mkokshoorn/Direct-Drive-Electric-Scooter/README.md

# Direct Drive Electric Scooter

This was a final year Electrical Engineering honours project to convert a children’s electric scooter to an electric direct drive scooter. The project achieved a very positive result. Its operation can be seen in the video provided in the main repository directory. A detailed overview of the project can be found in the report directory. Shown below is the scooter before the project began and after.

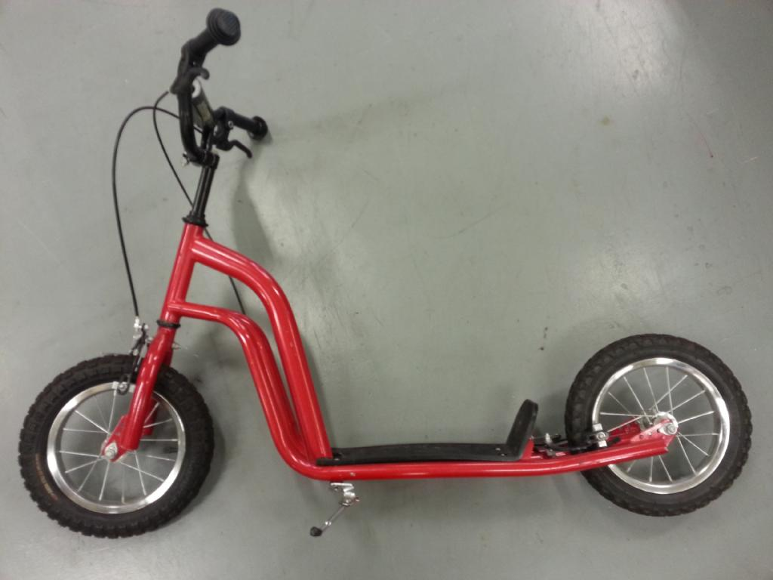
[picture p1: ScooterBefore.jpeg]

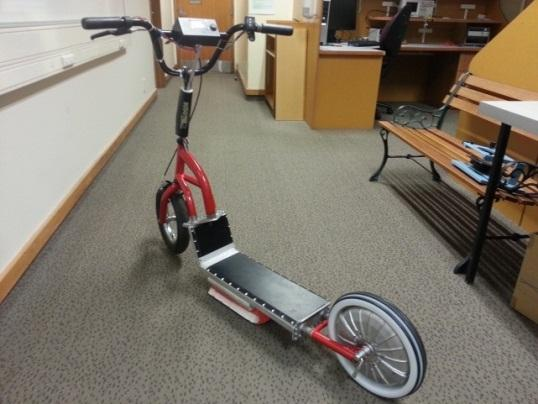
[picture p2: ScooterAfter.jpeg]


## System Overview 

Although this project was very hardware orientated, the source code for the embedded systems component has been provided. The embedded system is based on a PIC microcontroller. In addition to interpreting the user input and control signals, it also relayed information to the rider as shown below. 

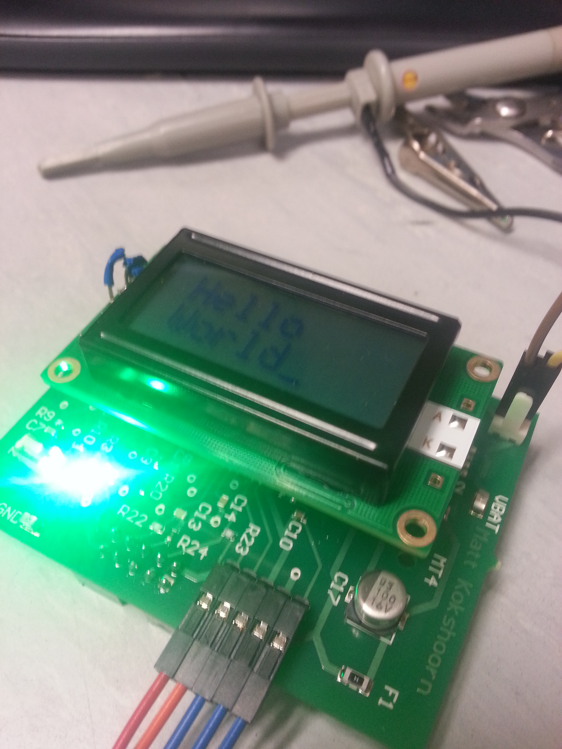
[picture p3: Multimedia/Board with LCD.jpg]


The microcontrollers full role in the system can also be seen in the following functional diagram.

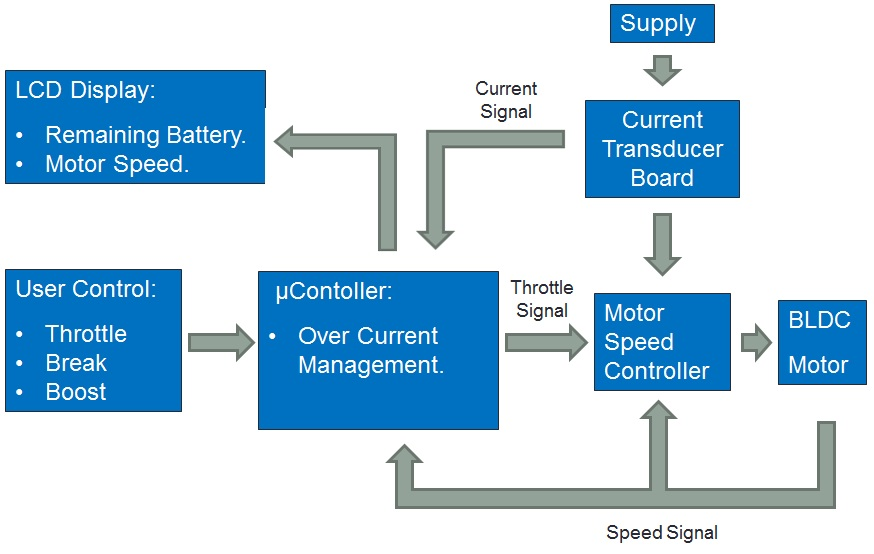
[picture p4: SystemOverview.jpg]


## Schematics and PCB Layouts

In the embedded system directory, the schematics and PCB files can also be found. They are also shown below.

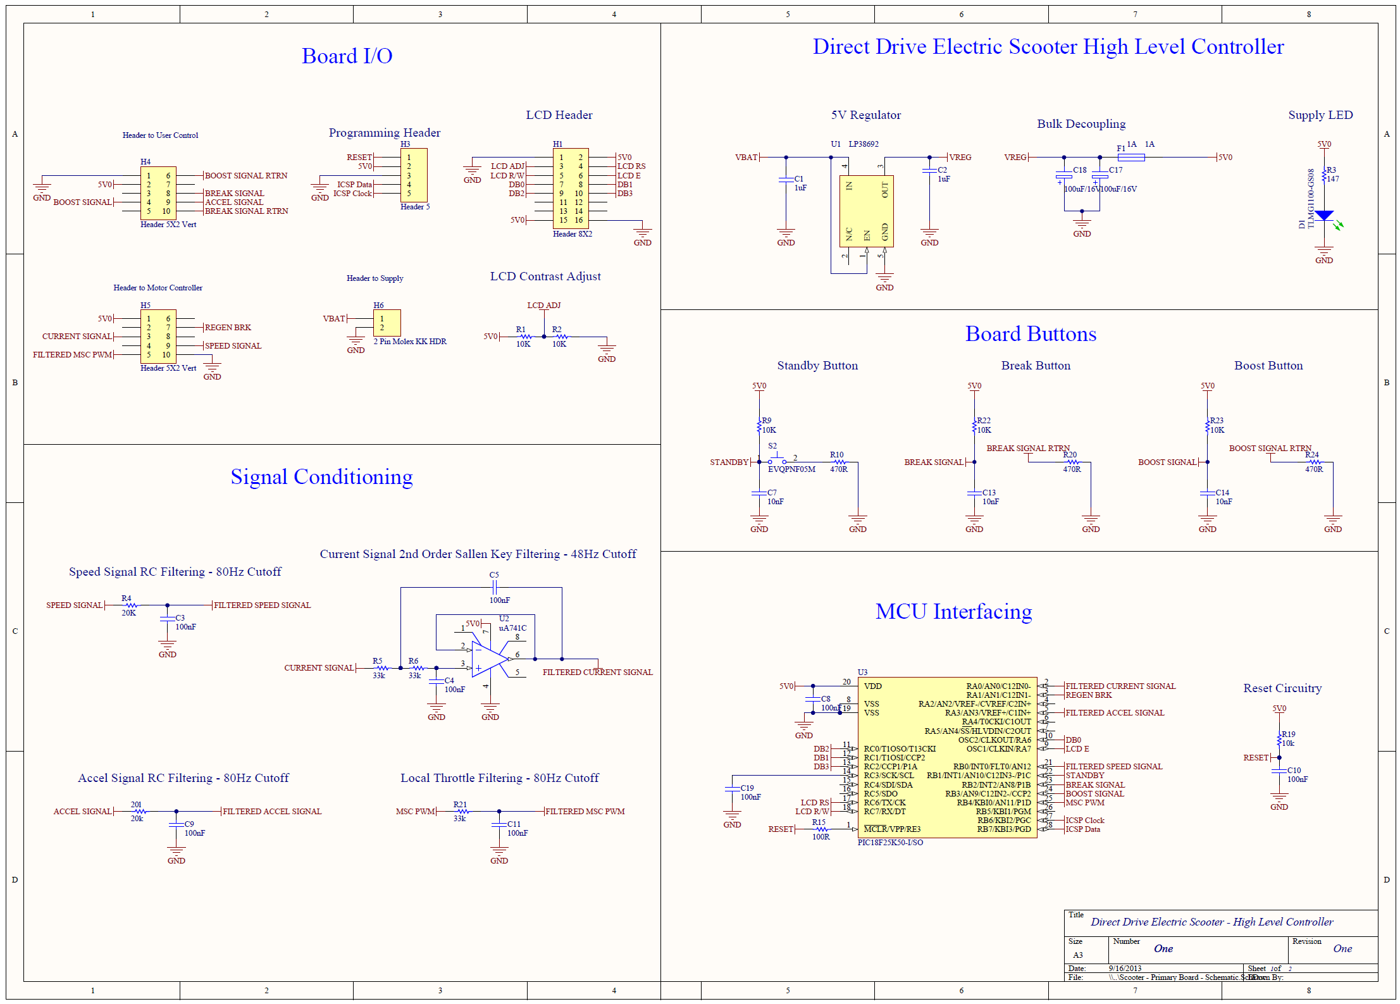
[picture p5: PrimaryBoardSchematic.png]

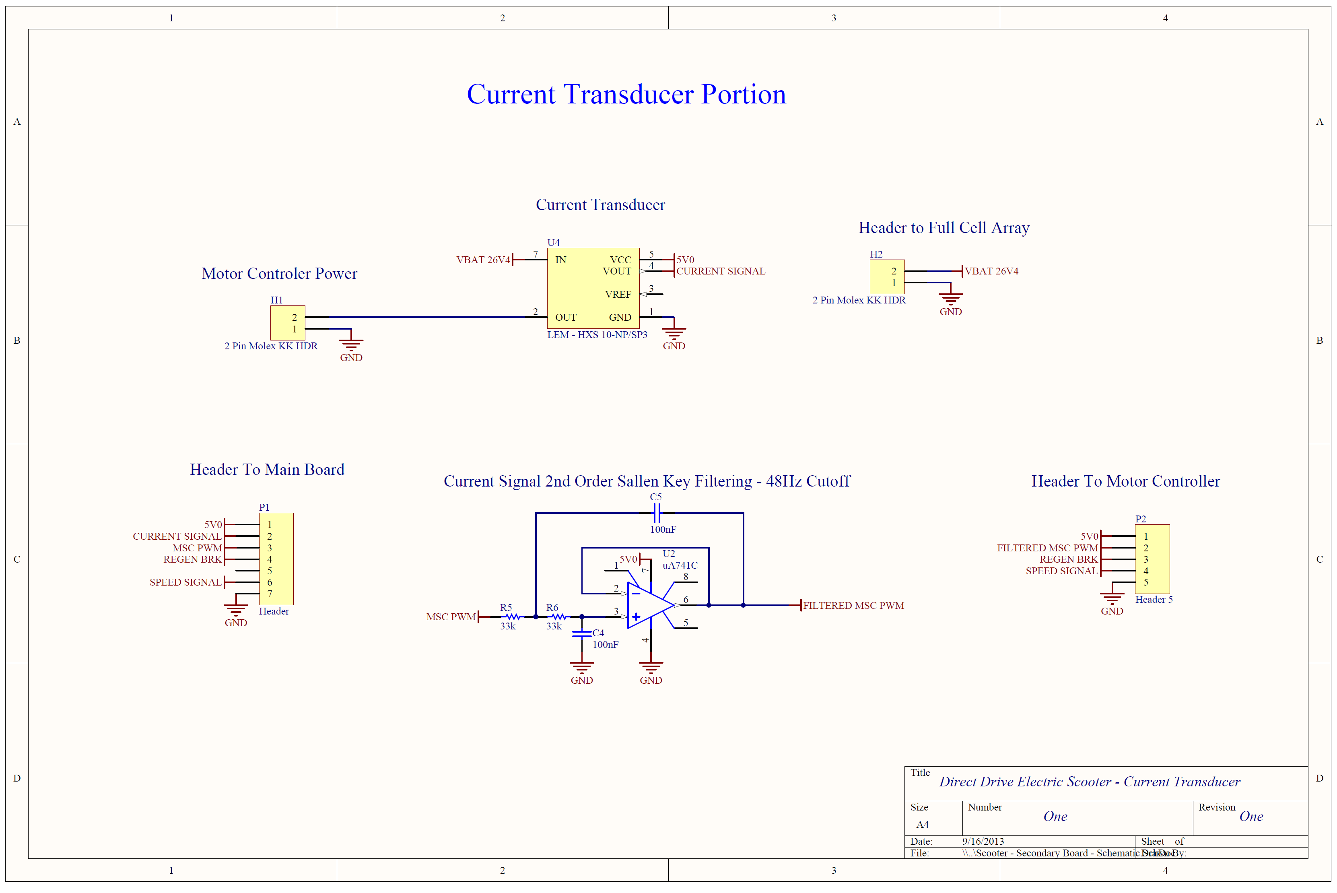
[picture p6: SecondaryBoardSchematic.png]

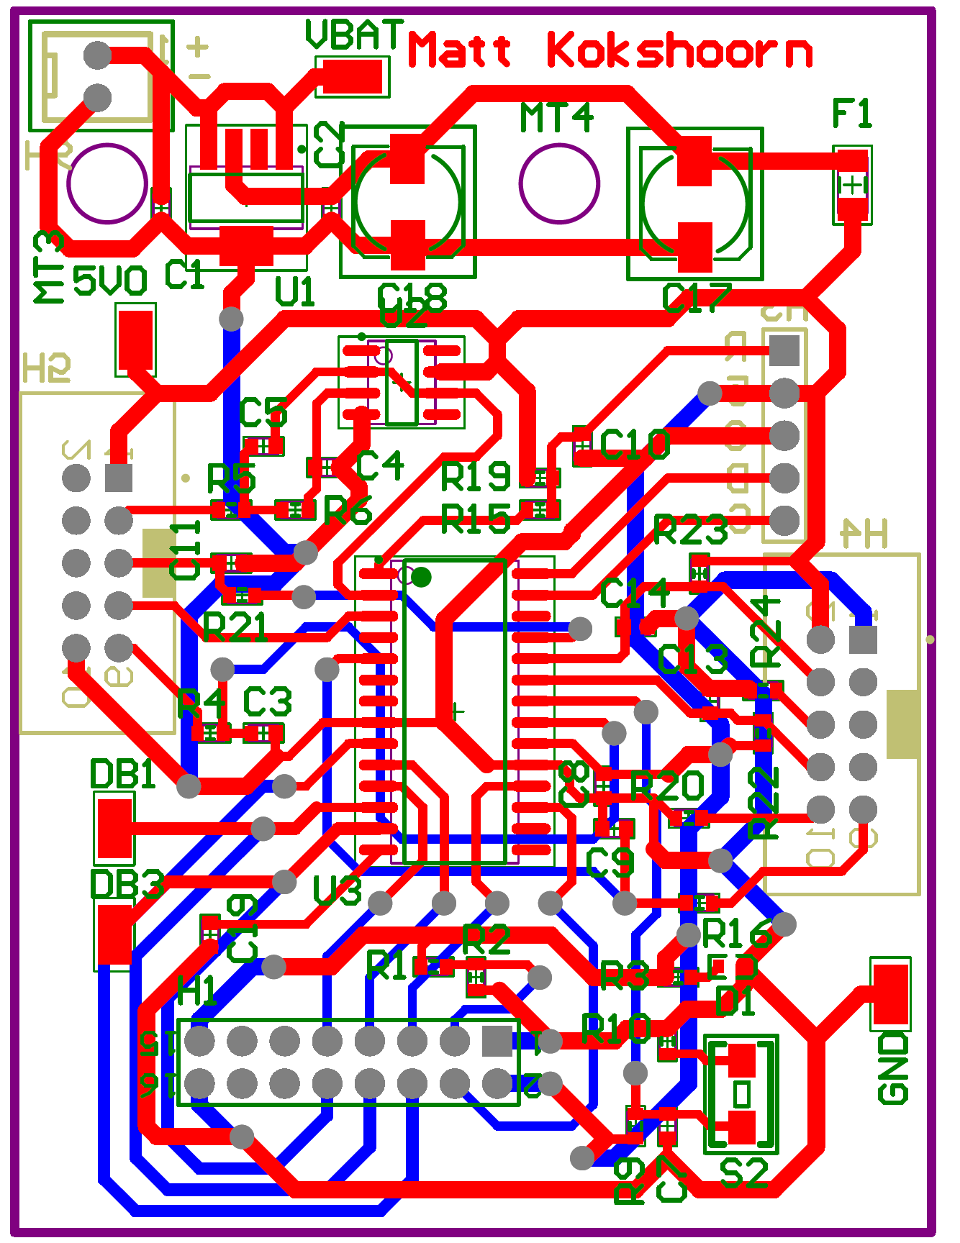
[picture p7: PrimaryBoardPCB.png]

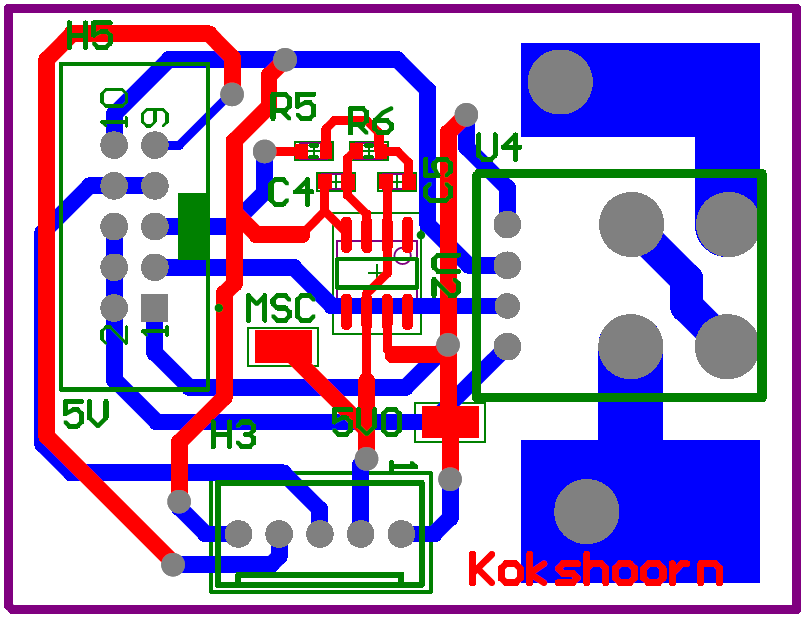
[picture p8: SecondaryBoardPCB.png]


## Solid Modeling 

In order to fabricate the battery housing, much of the frame was modeled in solid works as can be seen below.

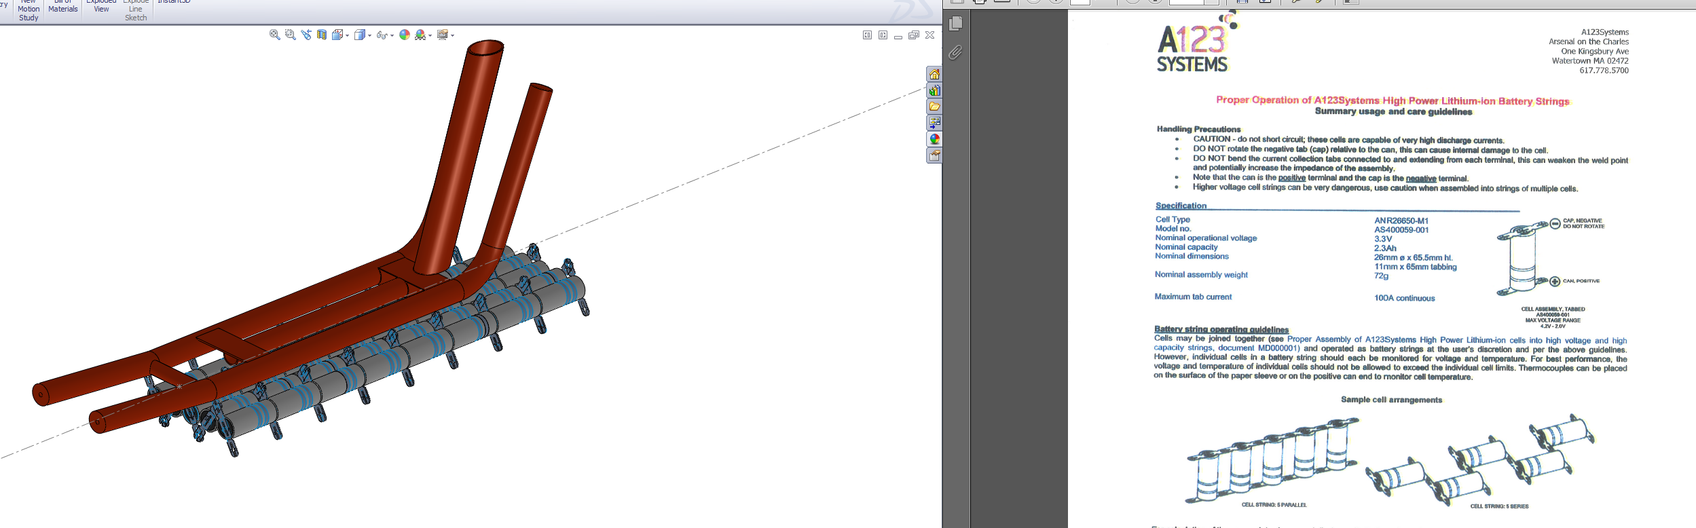
[picture p9: ScooterEarlyModel.png]

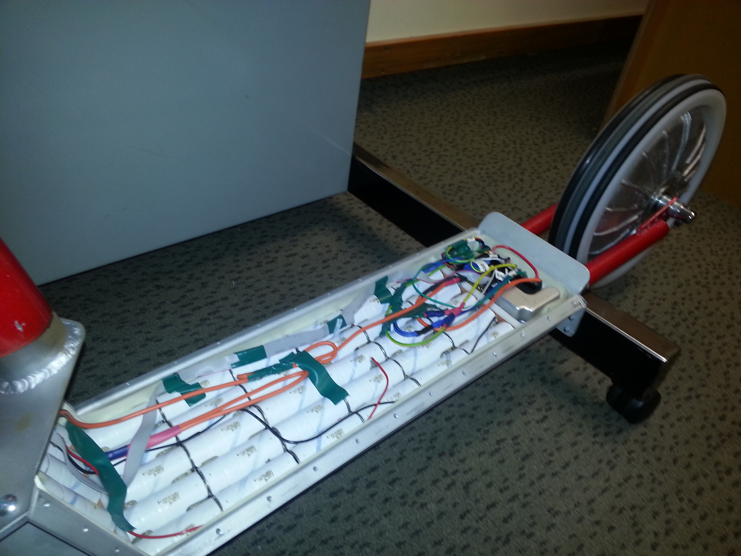
[picture p10: ScooterOpen.jpg]

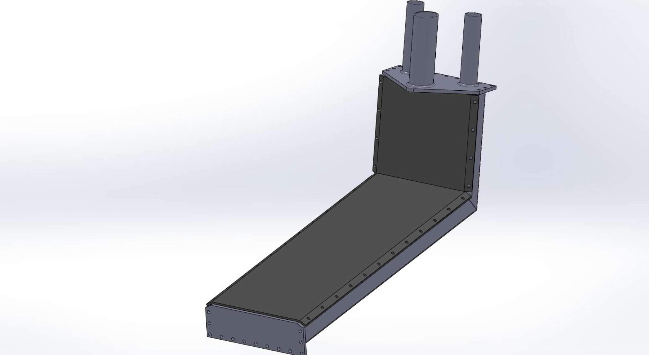
[picture p11: ScooterFinalModel.png]
