mkokshoorn/Direct-Drive-Electric-Scooter/JustBoard.jpg

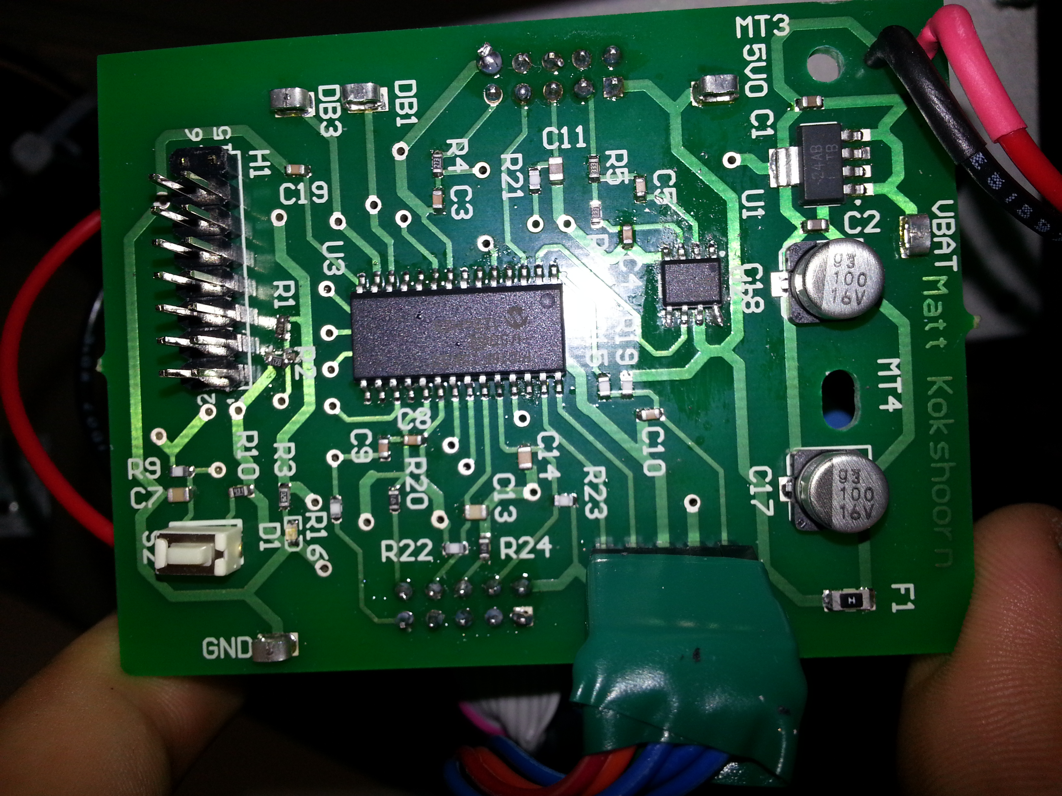
JustBoard.jpg
