mkokshoorn/Direct-Drive-Electric-Scooter/Multimedia/20130307_154826.jpg

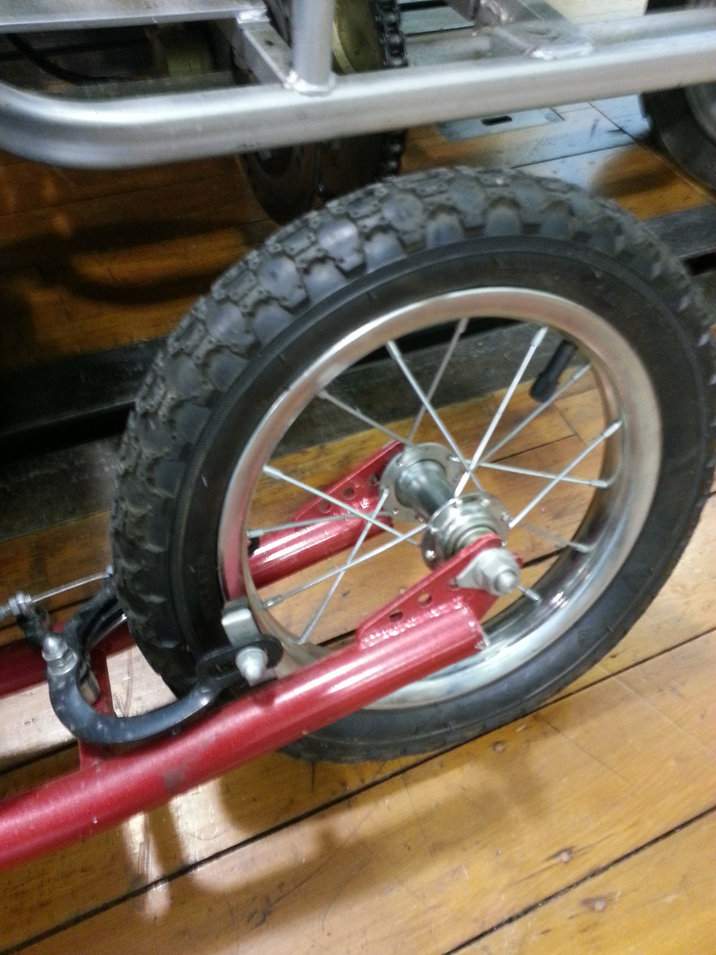
Multimedia/20130307_154826.jpg
