mkokshoorn/Direct-Drive-Electric-Scooter/Multimedia/20130307_154846.jpg

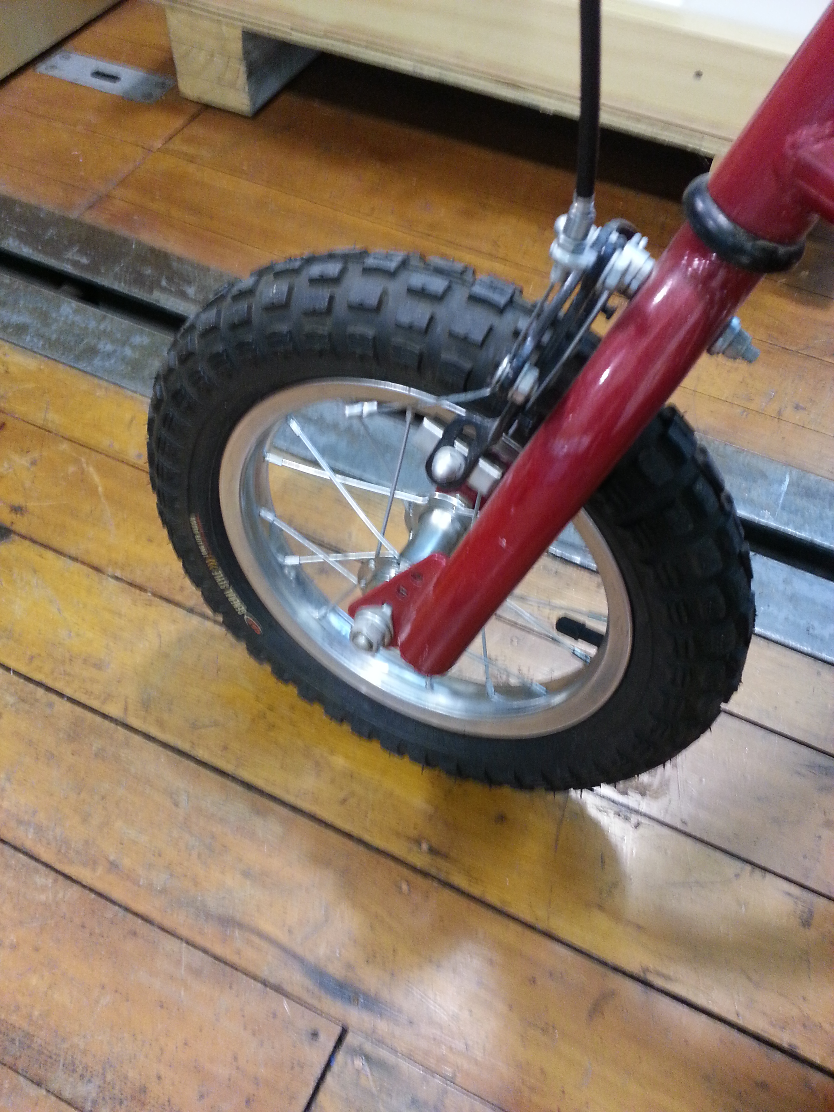
Multimedia/20130307_154846.jpg
