mkokshoorn/Direct-Drive-Electric-Scooter/Multimedia/20130307_154857.jpg

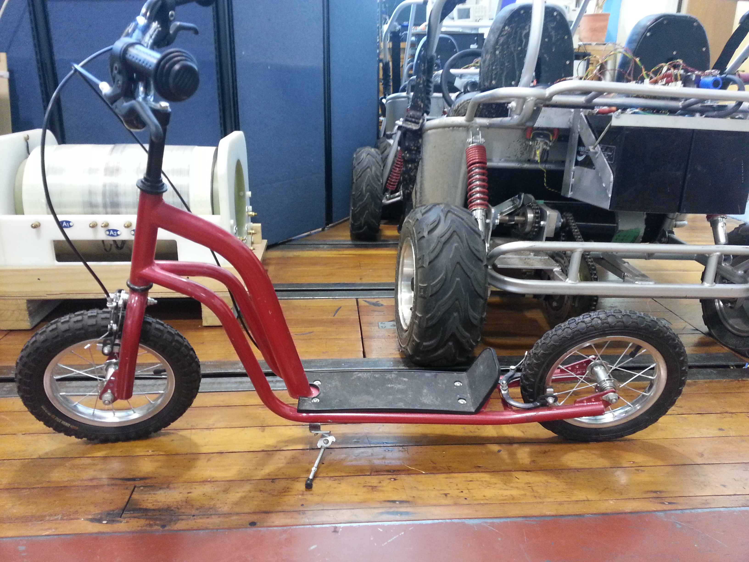
Multimedia/20130307_154857.jpg
