mkokshoorn/Direct-Drive-Electric-Scooter/Multimedia/20130307_154914.jpg

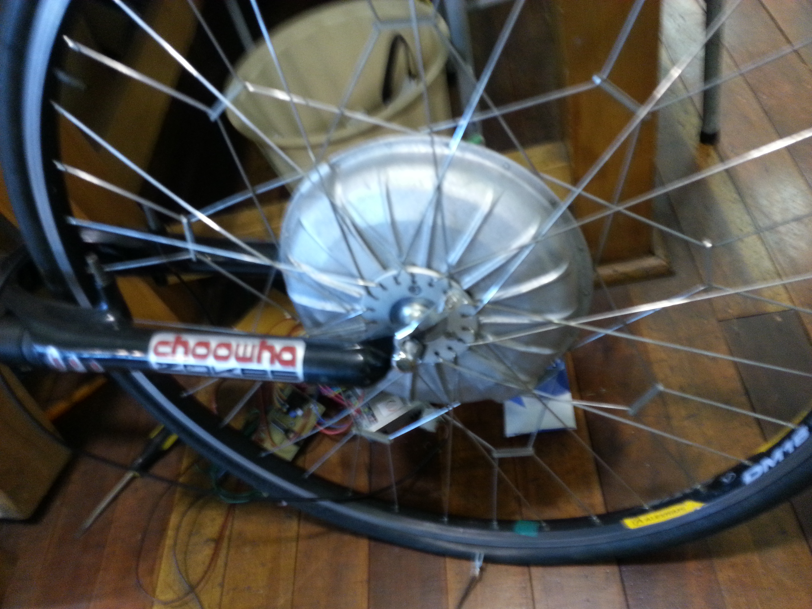
Multimedia/20130307_154914.jpg
