mkokshoorn/Direct-Drive-Electric-Scooter/Multimedia/20130312_115428.jpg

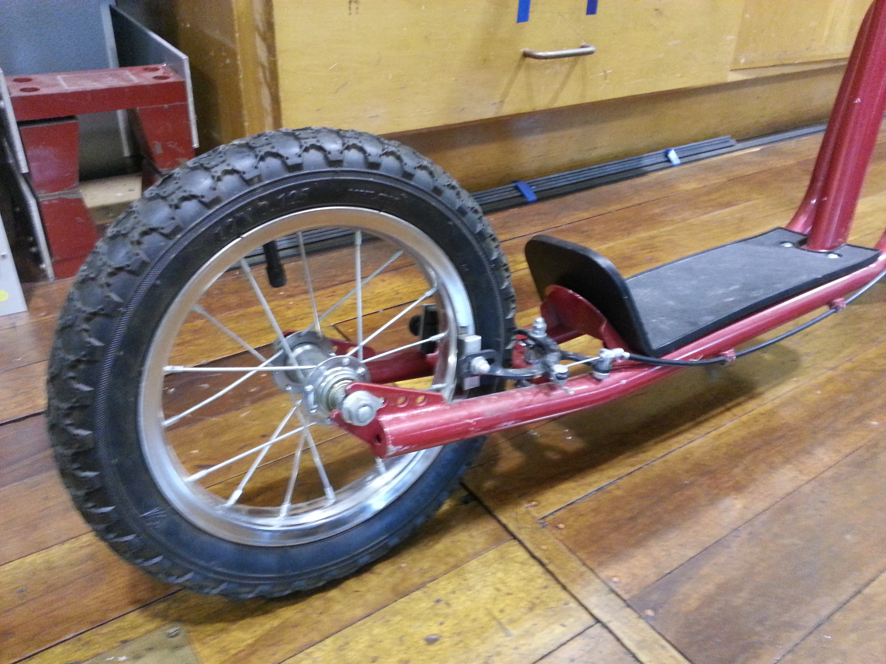
Multimedia/20130312_115428.jpg
