mkokshoorn/Direct-Drive-Electric-Scooter/Multimedia/20130312_115438.jpg

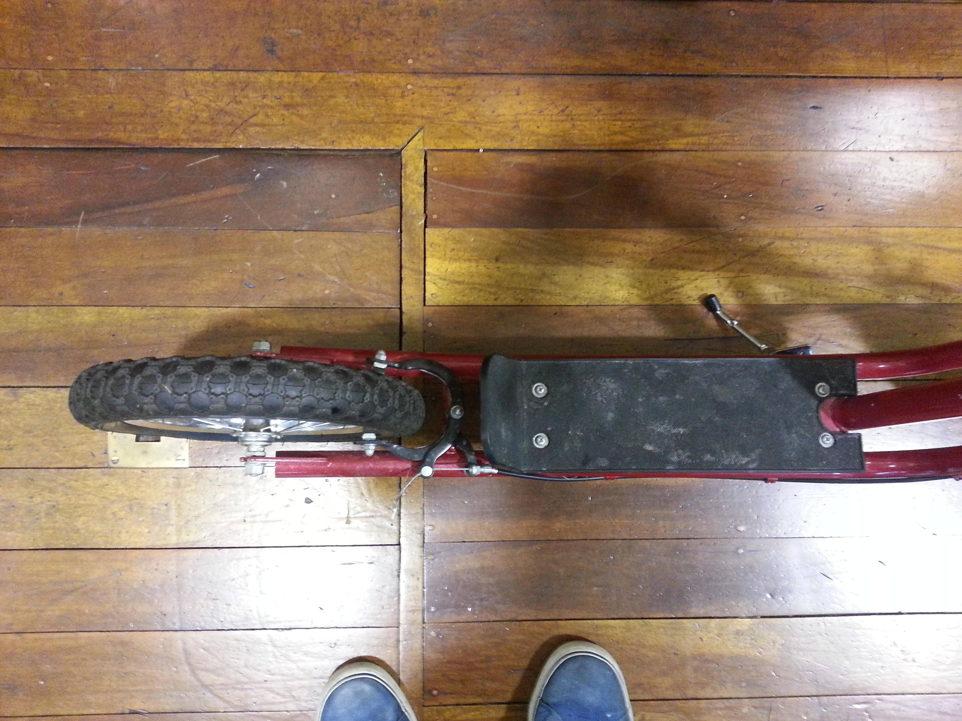
Multimedia/20130312_115438.jpg
