mkokshoorn/Direct-Drive-Electric-Scooter/Multimedia/20130312_115449.jpg

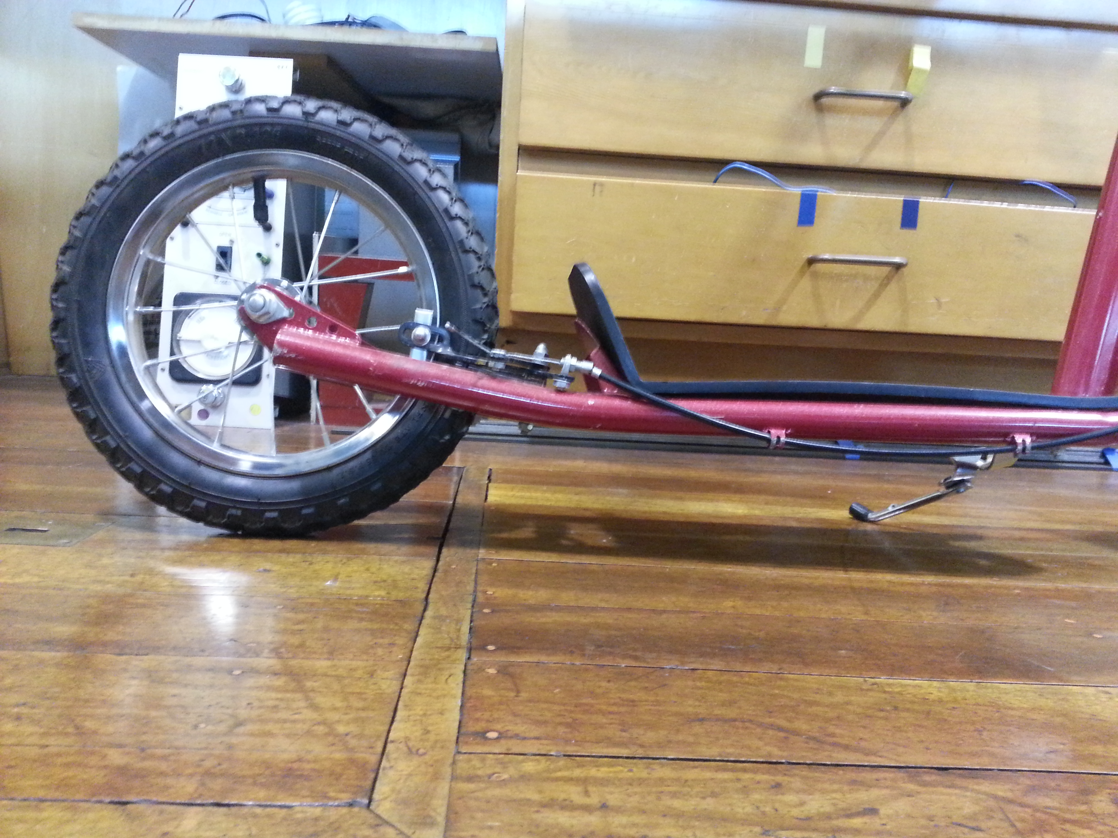
Multimedia/20130312_115449.jpg
