mkokshoorn/Direct-Drive-Electric-Scooter/Multimedia/20130312_115455.jpg

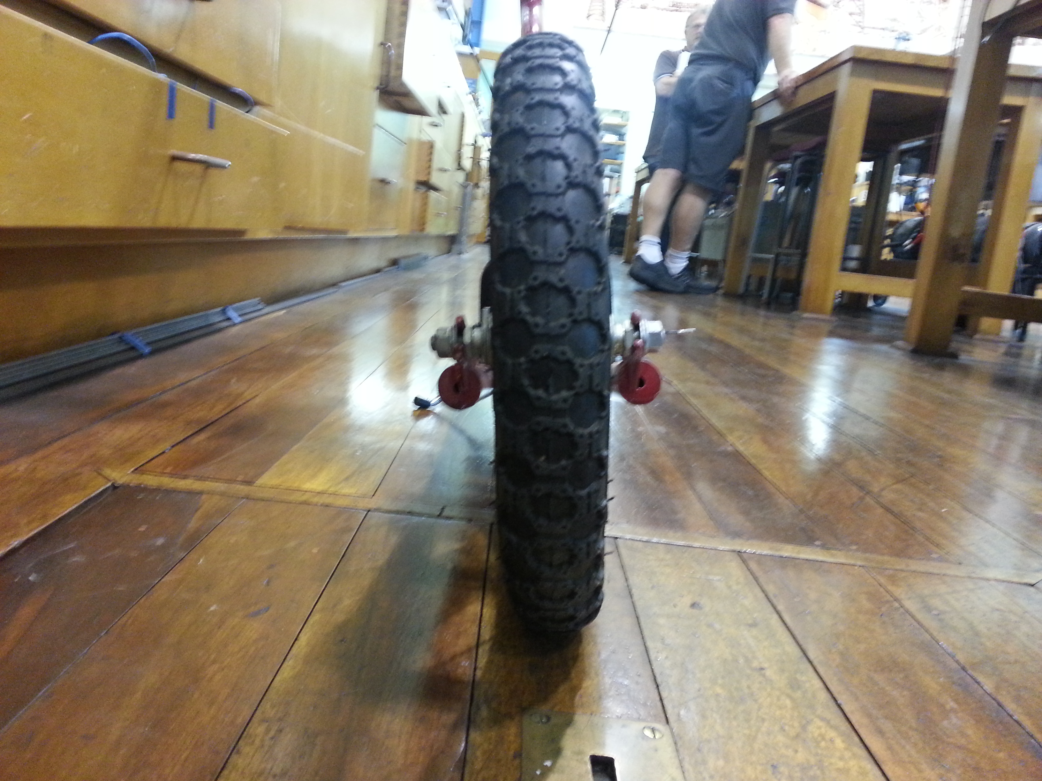
Multimedia/20130312_115455.jpg
