mkokshoorn/Direct-Drive-Electric-Scooter/Multimedia/20130312_115504.jpg

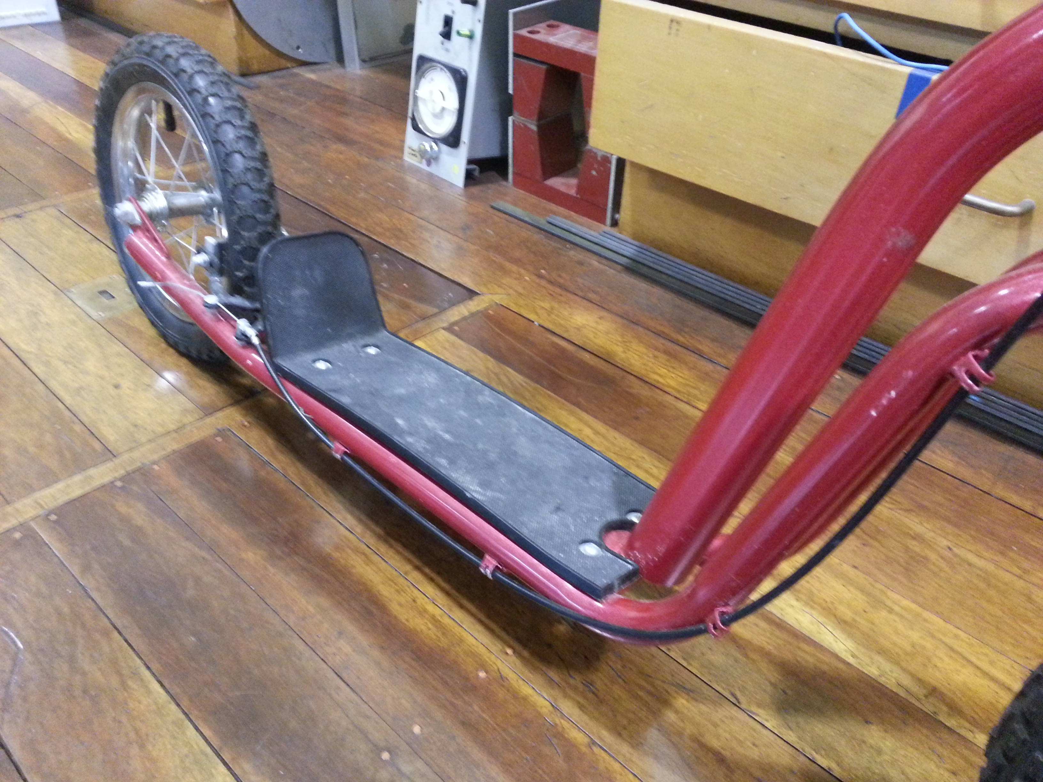
Multimedia/20130312_115504.jpg
