mkokshoorn/Direct-Drive-Electric-Scooter/Multimedia/20130312_115529.jpg

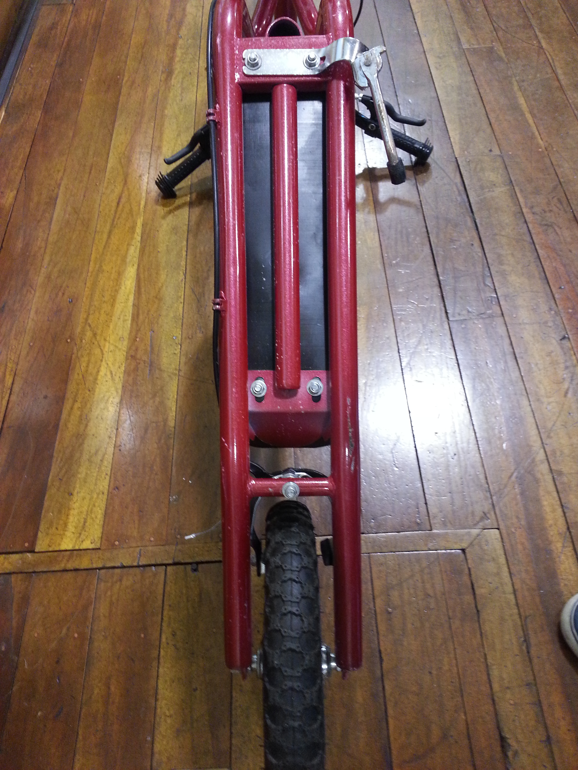
Multimedia/20130312_115529.jpg
