mkokshoorn/Direct-Drive-Electric-Scooter/Multimedia/20130312_115534.jpg

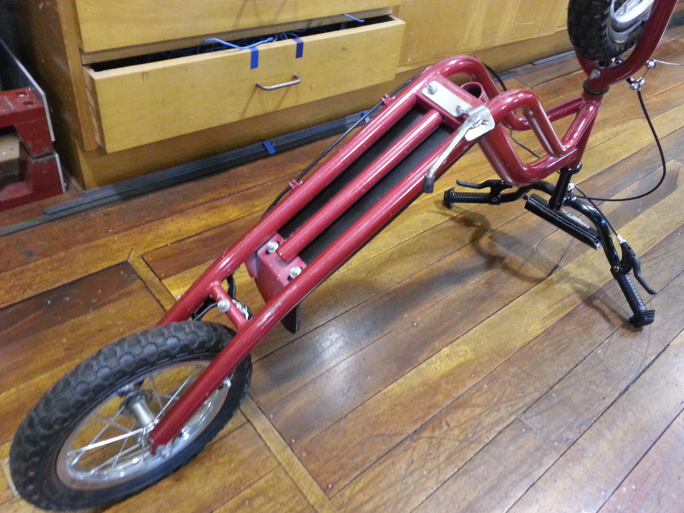
Multimedia/20130312_115534.jpg
