mkokshoorn/Direct-Drive-Electric-Scooter/Multimedia/20130312_115544.jpg

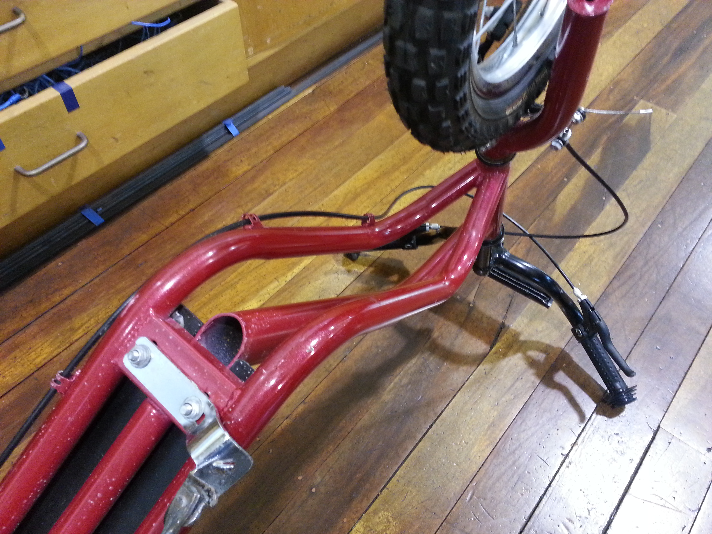
Multimedia/20130312_115544.jpg
