mkokshoorn/Direct-Drive-Electric-Scooter/Multimedia/20130312_131556.jpg

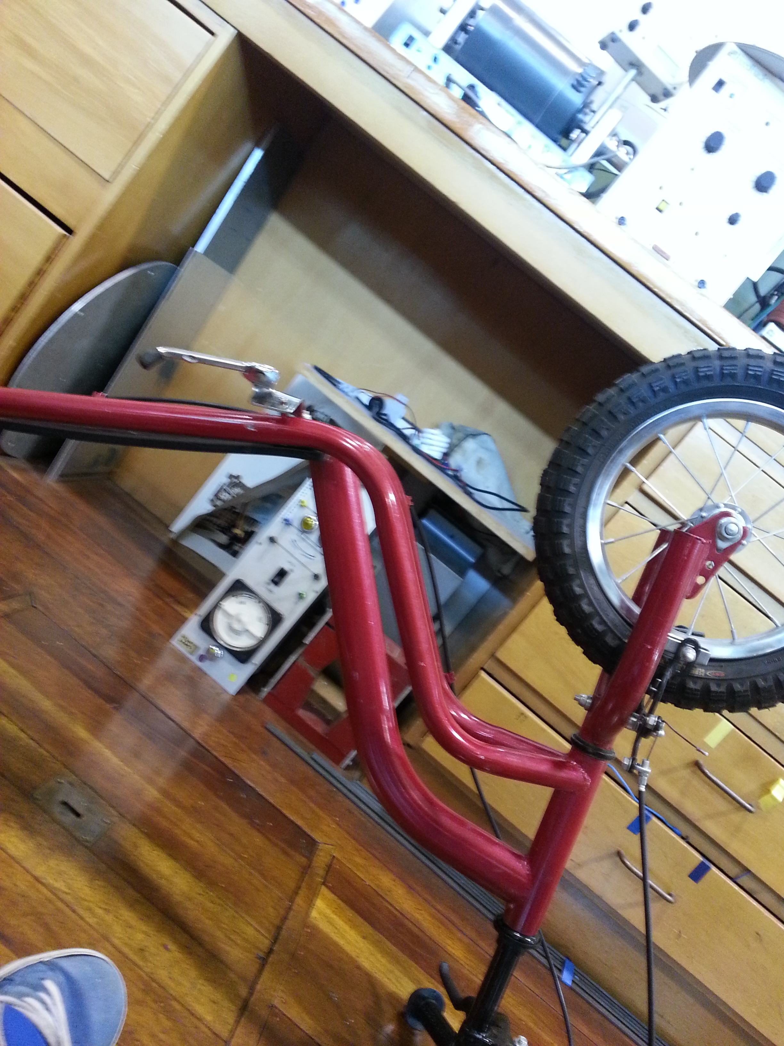
Multimedia/20130312_131556.jpg
