mkokshoorn/Direct-Drive-Electric-Scooter/Multimedia/20130408_163224(0).jpg

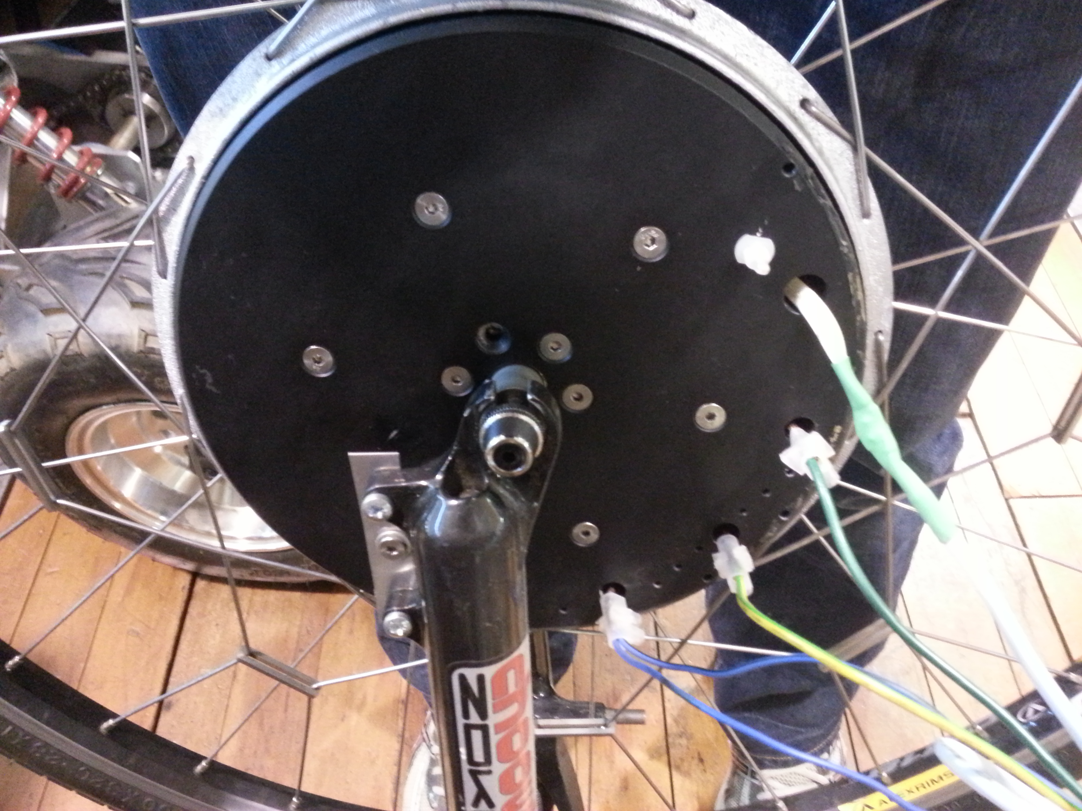
Multimedia/20130408_163224(0).jpg
