mkokshoorn/Direct-Drive-Electric-Scooter/Multimedia/20130417_151900.jpg

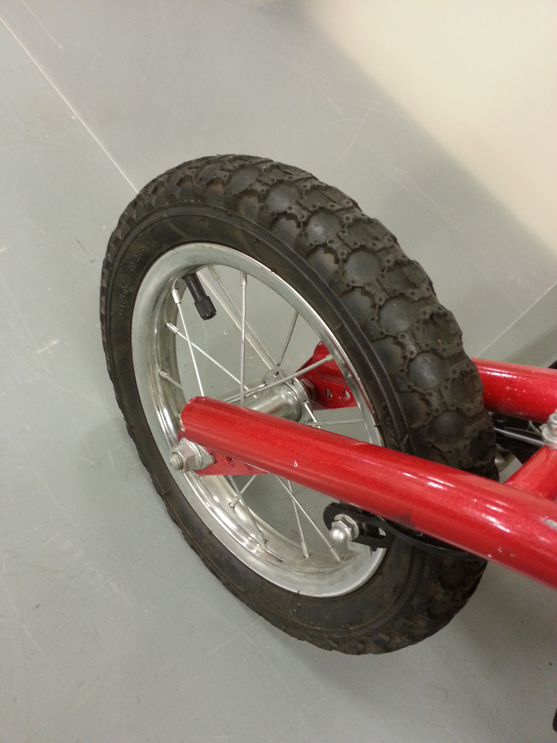
Multimedia/20130417_151900.jpg
