mkokshoorn/Direct-Drive-Electric-Scooter/Multimedia/20130501_132422.jpg

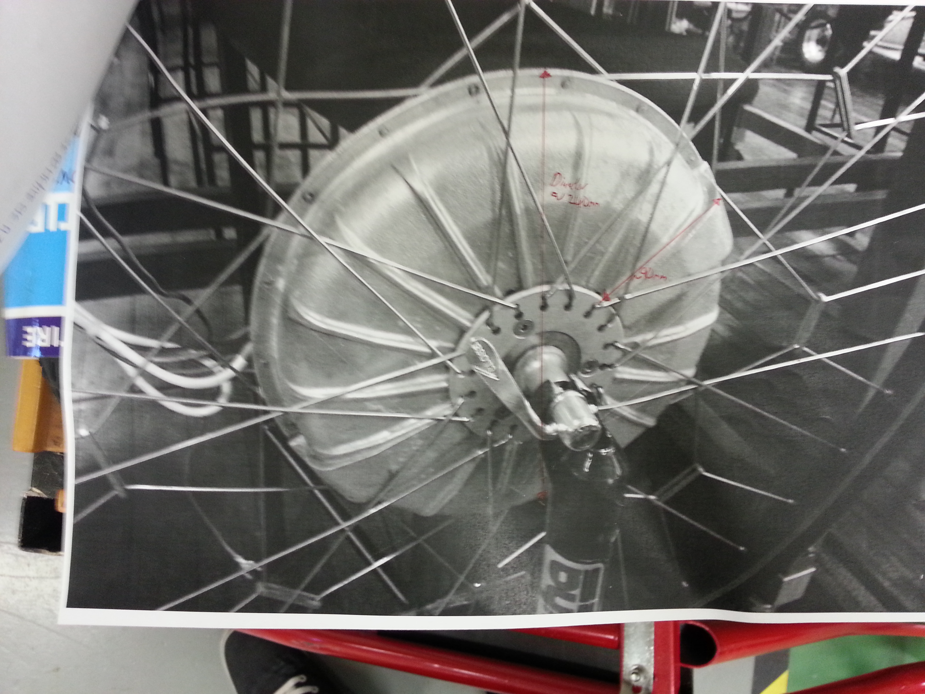
Multimedia/20130501_132422.jpg
