mkokshoorn/Direct-Drive-Electric-Scooter/Multimedia/20130605_151343.jpg

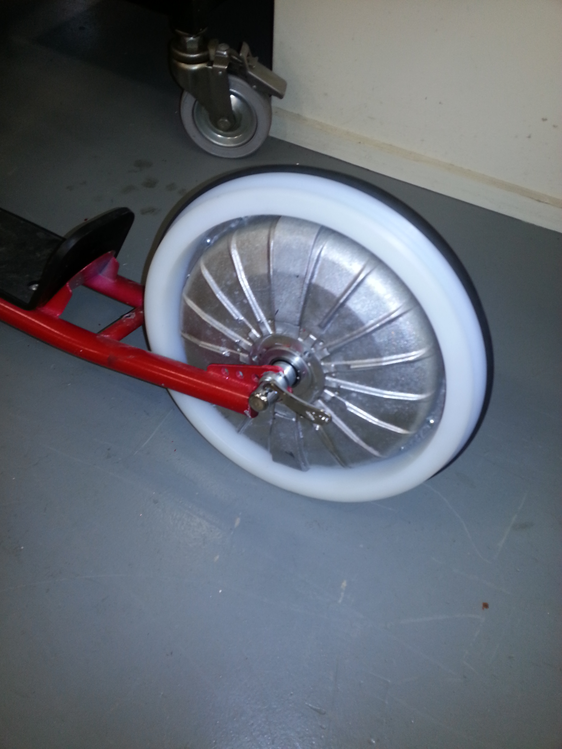
Multimedia/20130605_151343.jpg
