mkokshoorn/Direct-Drive-Electric-Scooter/Multimedia/20130605_152956.jpg

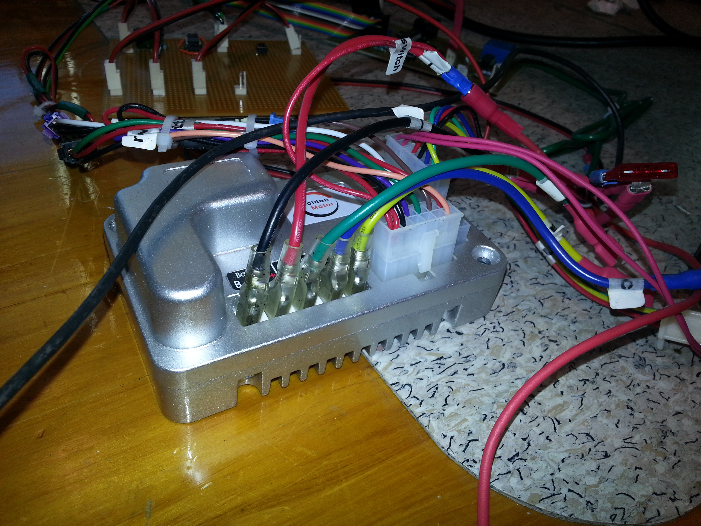
Multimedia/20130605_152956.jpg
