mkokshoorn/Direct-Drive-Electric-Scooter/Multimedia/20130628_161116.jpg

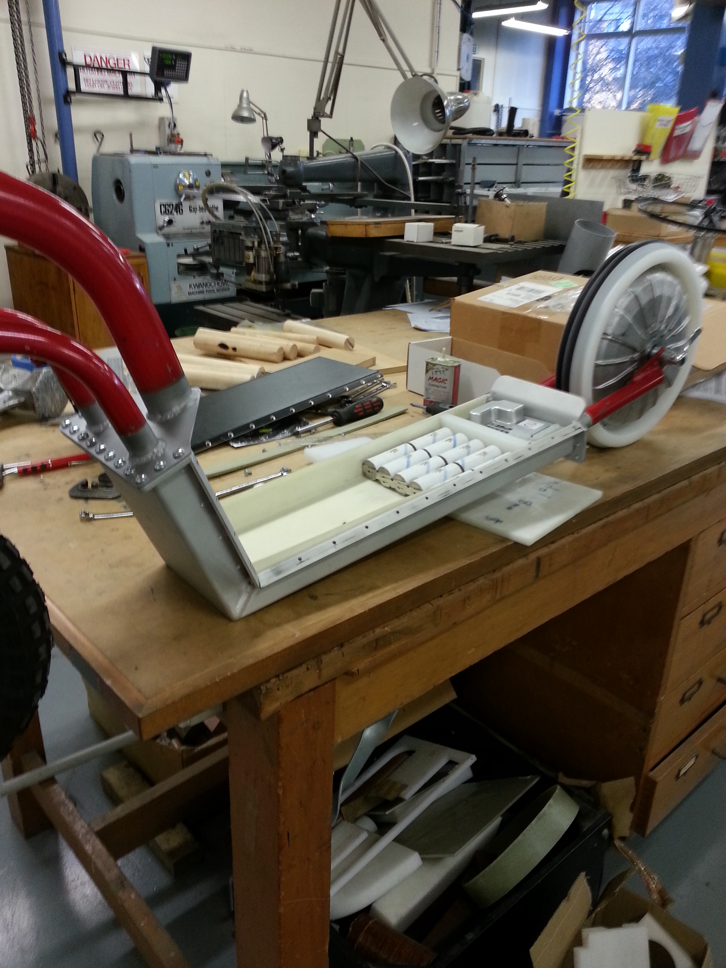
Multimedia/20130628_161116.jpg
