mkokshoorn/Direct-Drive-Electric-Scooter/Multimedia/20130628_161121.jpg

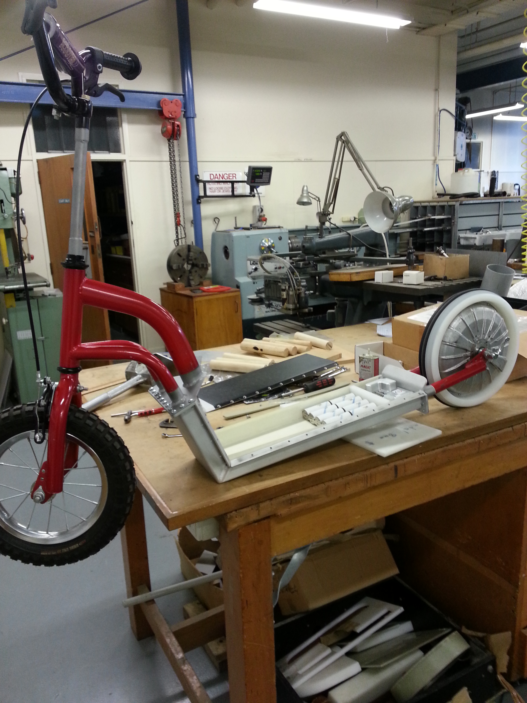
Multimedia/20130628_161121.jpg
