mkokshoorn/Direct-Drive-Electric-Scooter/Multimedia/20130726_152837.jpg

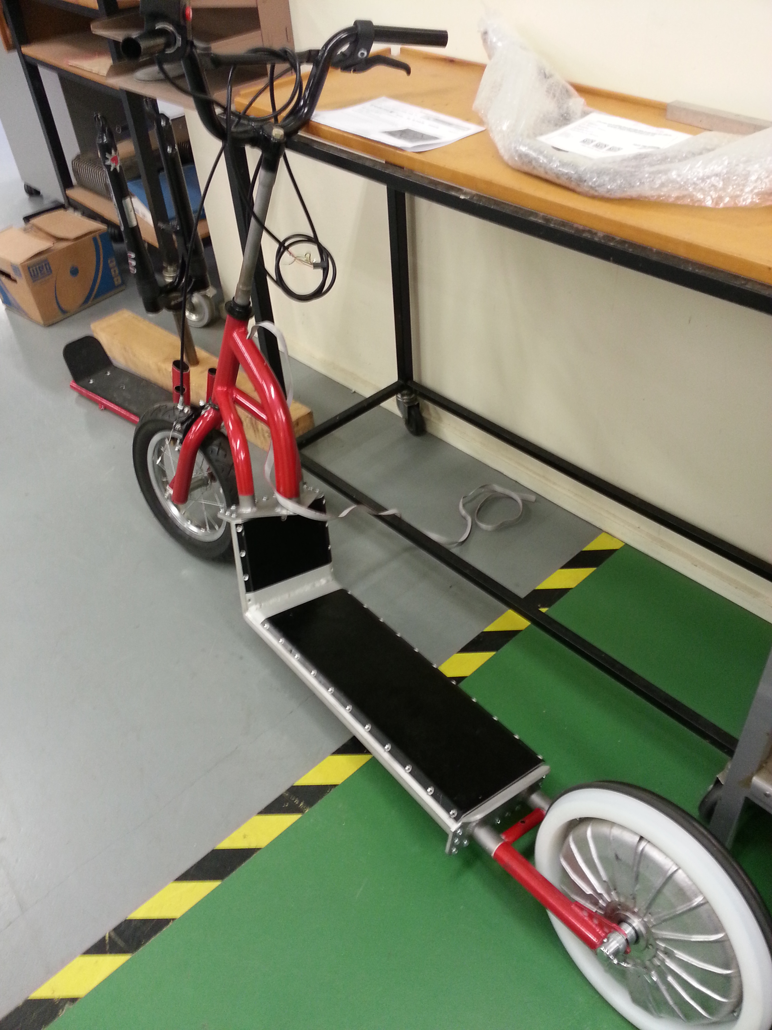
Multimedia/20130726_152837.jpg
