mkokshoorn/Direct-Drive-Electric-Scooter/Multimedia/20130726_152845.jpg

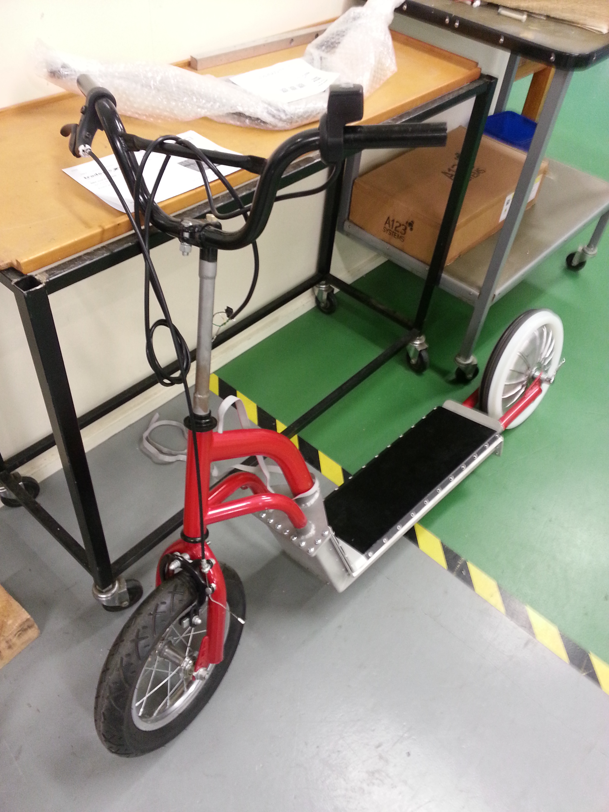
Multimedia/20130726_152845.jpg
