mkokshoorn/Direct-Drive-Electric-Scooter/Multimedia/20130810_022343.jpg

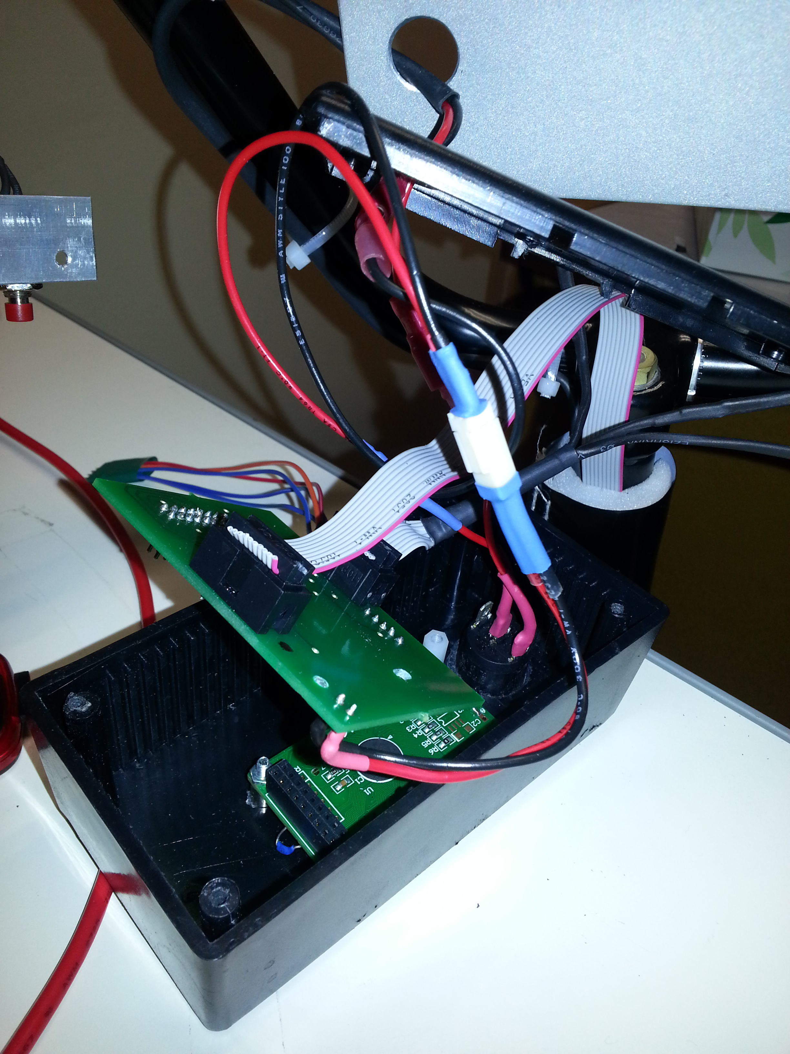
Multimedia/20130810_022343.jpg
