mkokshoorn/Direct-Drive-Electric-Scooter/Multimedia/20130810_022358.jpg

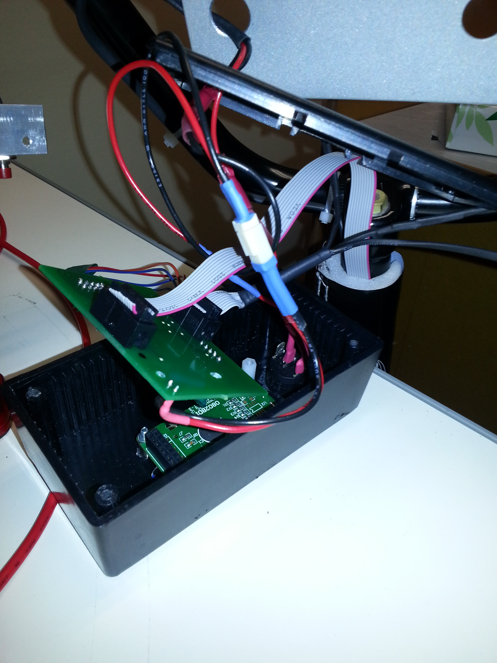
Multimedia/20130810_022358.jpg
