mkokshoorn/Direct-Drive-Electric-Scooter/Multimedia/20130816_091537.jpg

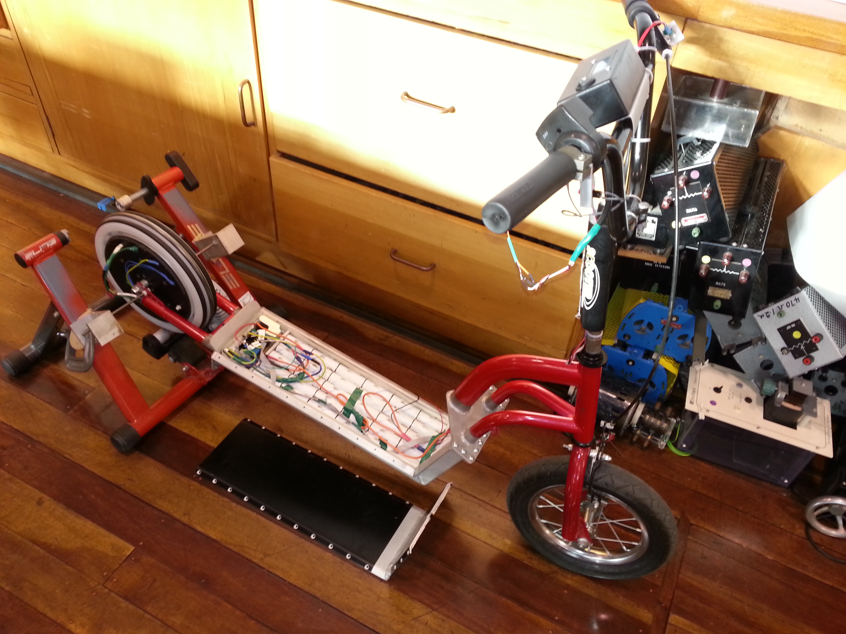
Multimedia/20130816_091537.jpg
