mkokshoorn/Direct-Drive-Electric-Scooter/Multimedia/20130816_102537.jpg

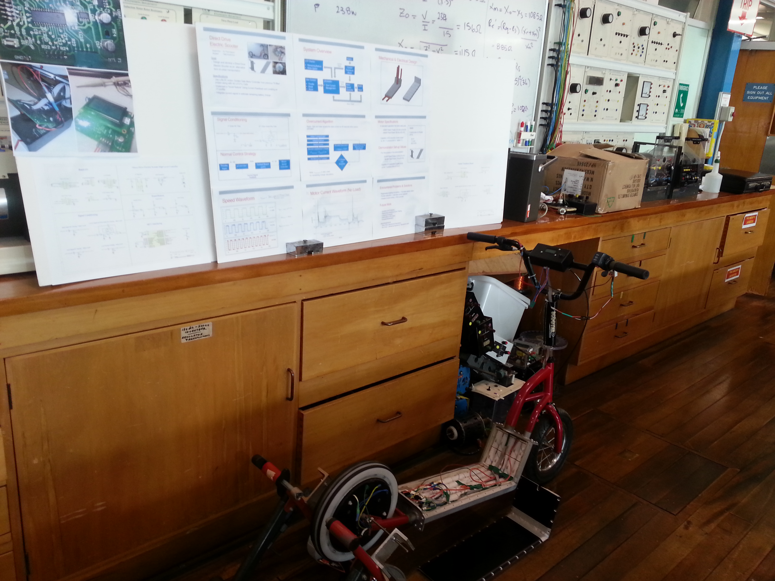
Multimedia/20130816_102537.jpg
