mkokshoorn/Direct-Drive-Electric-Scooter/Multimedia/Batteries__no_gaps.png

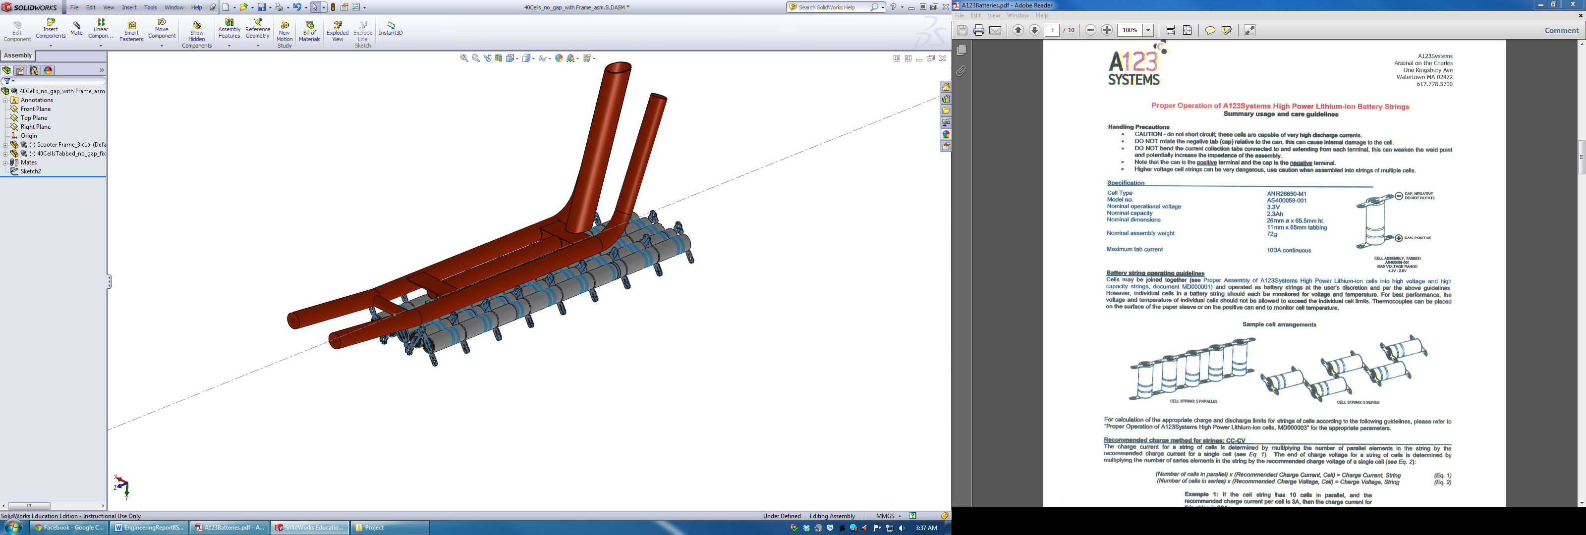
Multimedia/Batteries__no_gaps.png
