mkokshoorn/Direct-Drive-Electric-Scooter/Raw_Scope_Data/scope_1.bmp

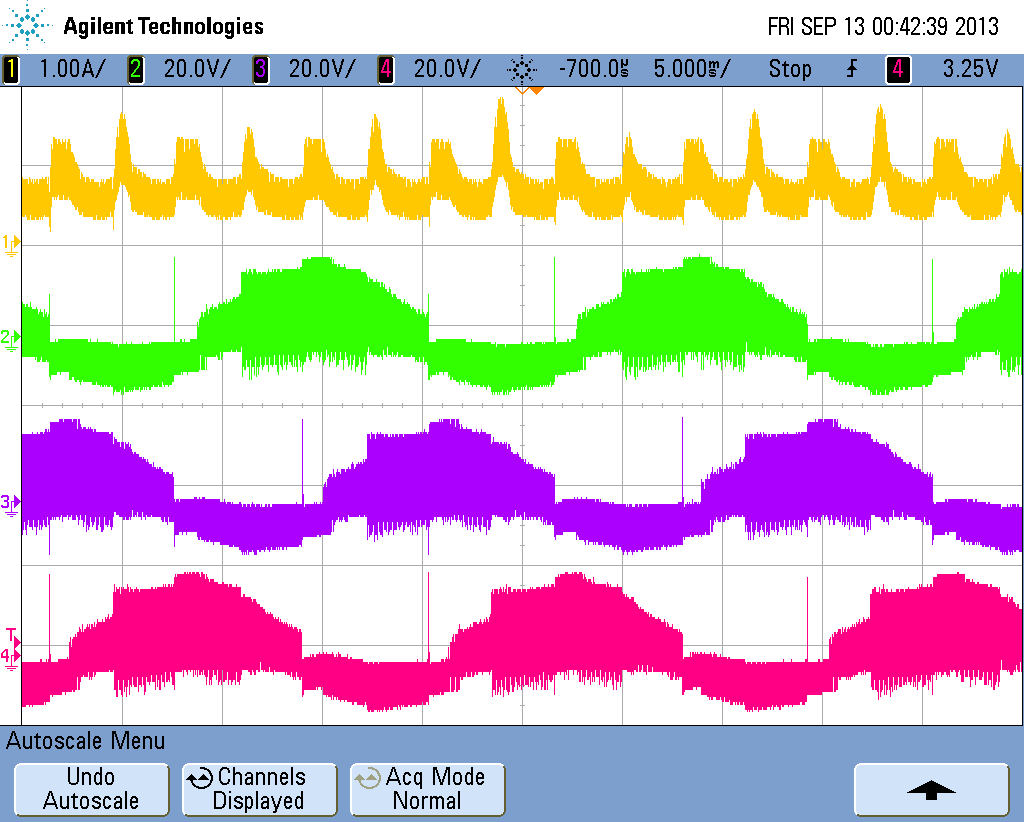
Raw_Scope_Data/scope_1.bmp
