mkokshoorn/Direct-Drive-Electric-Scooter/Raw_Scope_Data/scope_4.bmp

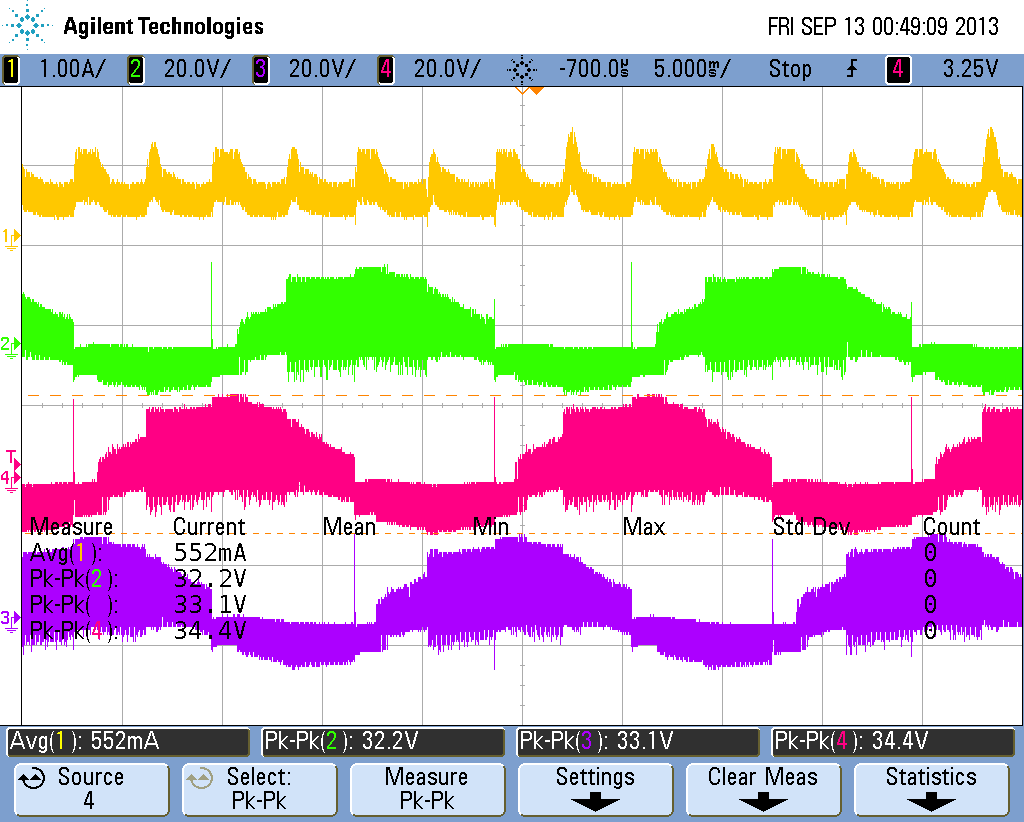
Raw_Scope_Data/scope_4.bmp
