mkokshoorn/Direct-Drive-Electric-Scooter/Embedded_System/Primary_Circuit/Scooter - Primary Board - Project .pdf

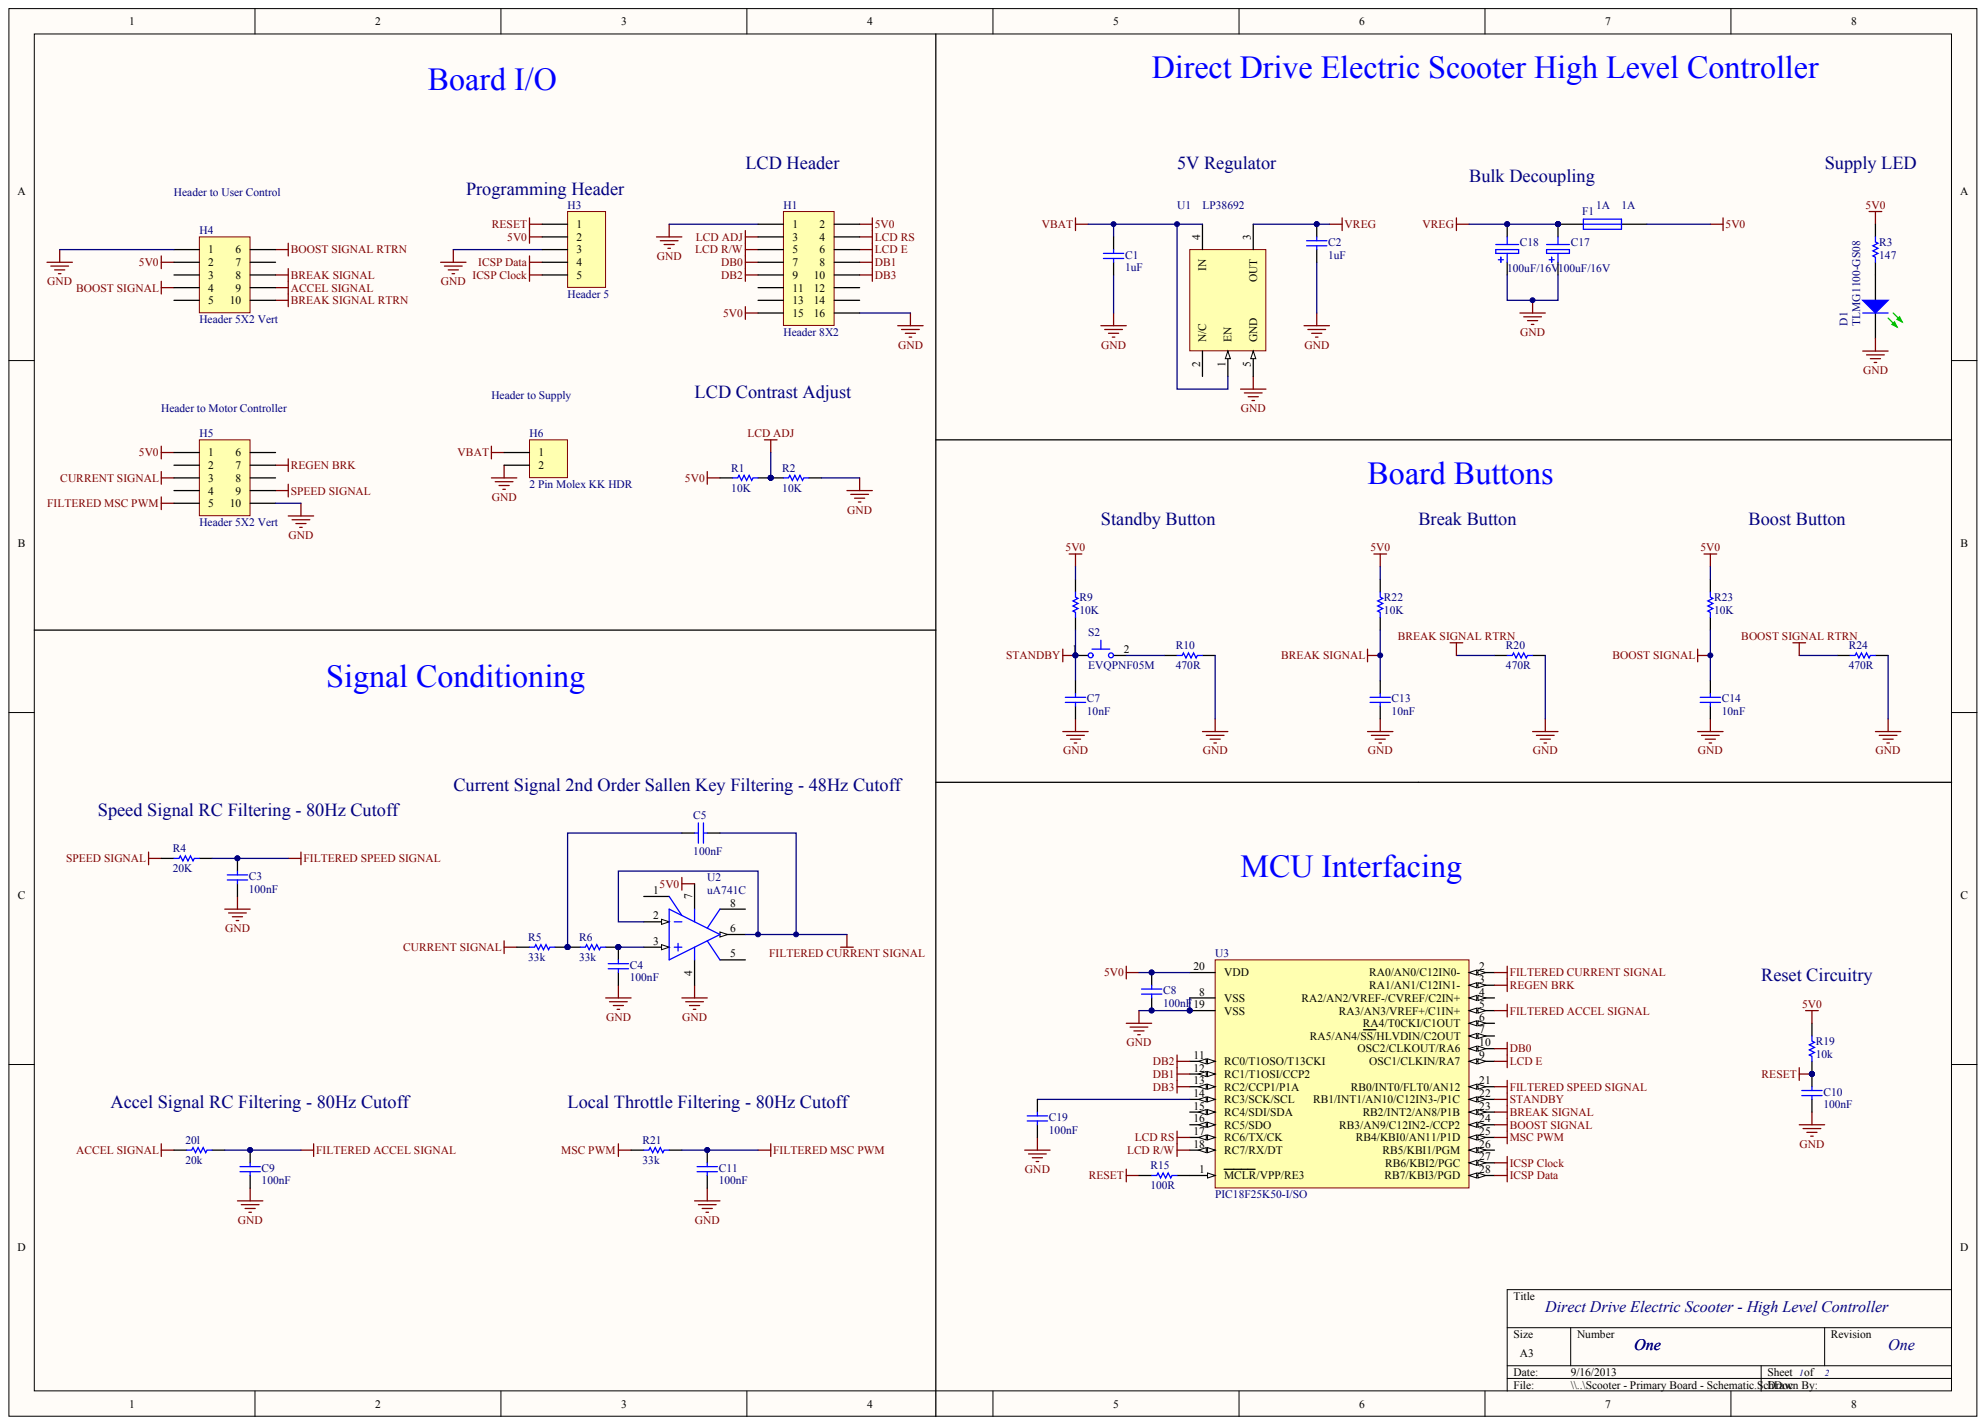
[picture p99: page 1]

Direct Drive Electric Scooter High Level Controller

Header to User Control

Header to Motor Controller

2 Pin Molex KK HDR 12

Current Signal 2nd Order Sallen Key Filtering - 48Hz Cutoff

Speed Signal RC Filtering - 80Hz Cutoff

Accel Signal RC Filtering - 80Hz Cutoff

Local Throttle Filtering - 80Hz Cutoff

Title
Direct Drive Electric Scooter - High Level Controller

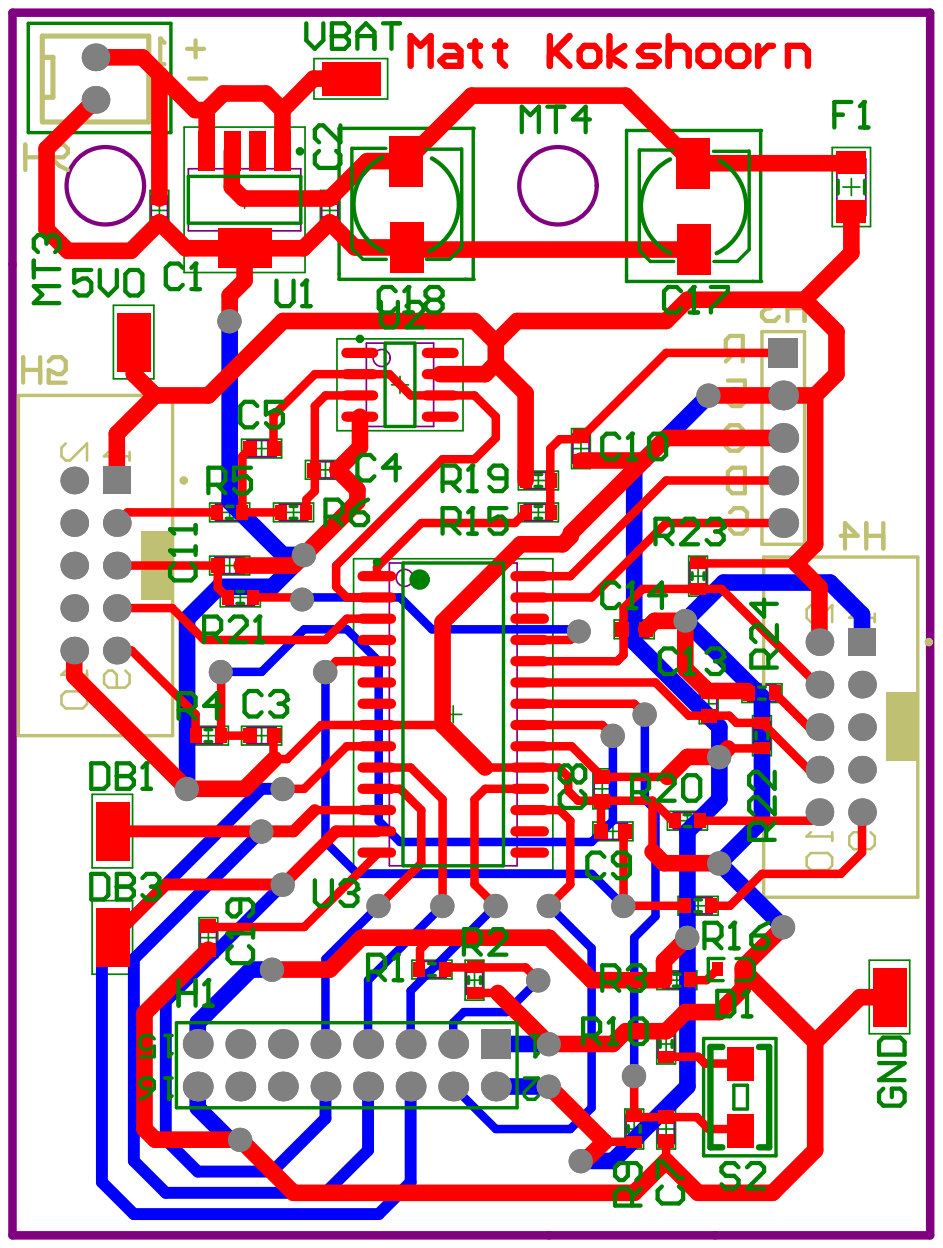
[picture p100: page 2]

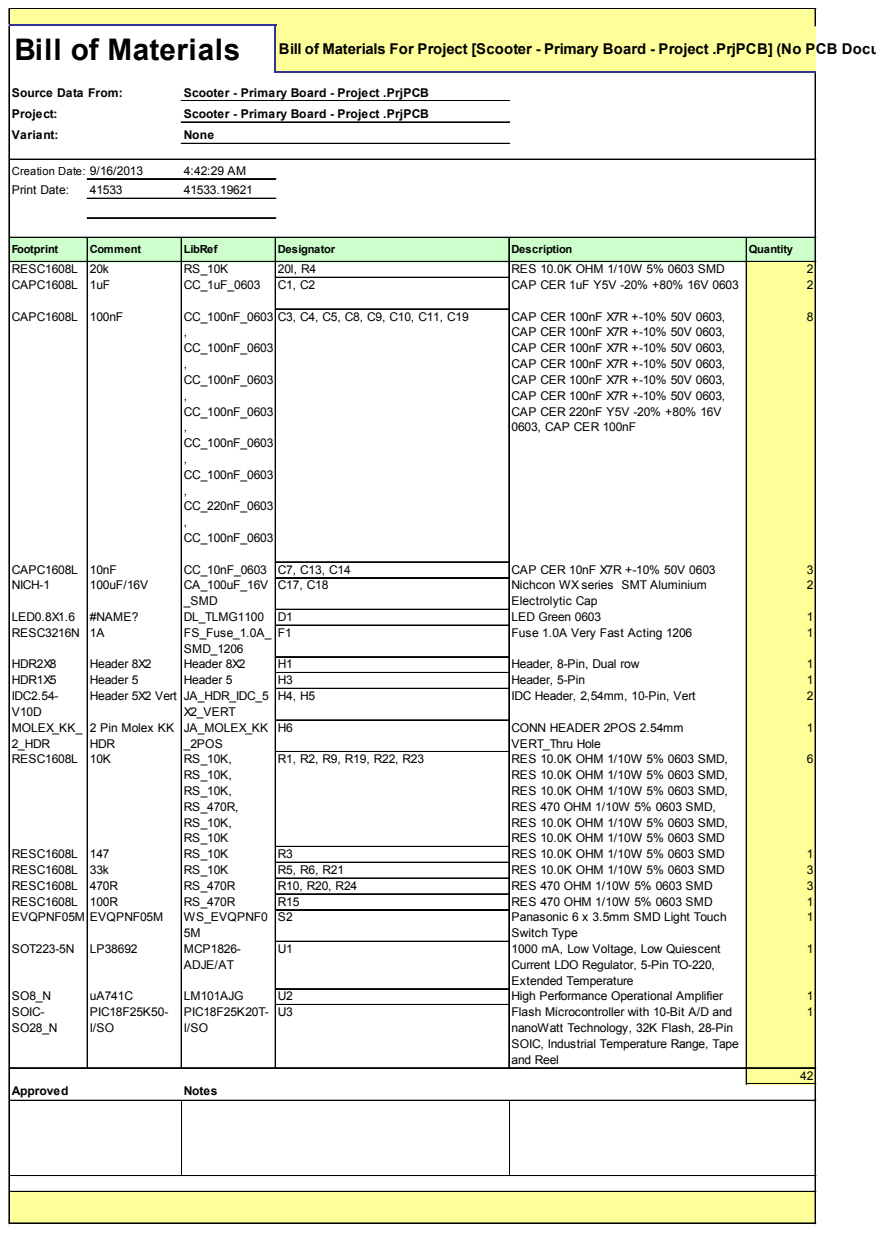
[picture p101: page 3]

Current LDO Regulator, 5-Pin TO-220,
Extended Temperature

nanoWatt Technology, 32K Flash, 28-Pin
SOIC, Industrial Temperature Range, Tape
and Reel
