mkokshoorn/Direct-Drive-Electric-Scooter/Embedded_System/Secondary_Circuit/Scooter - Secondary Board - Project.pdf

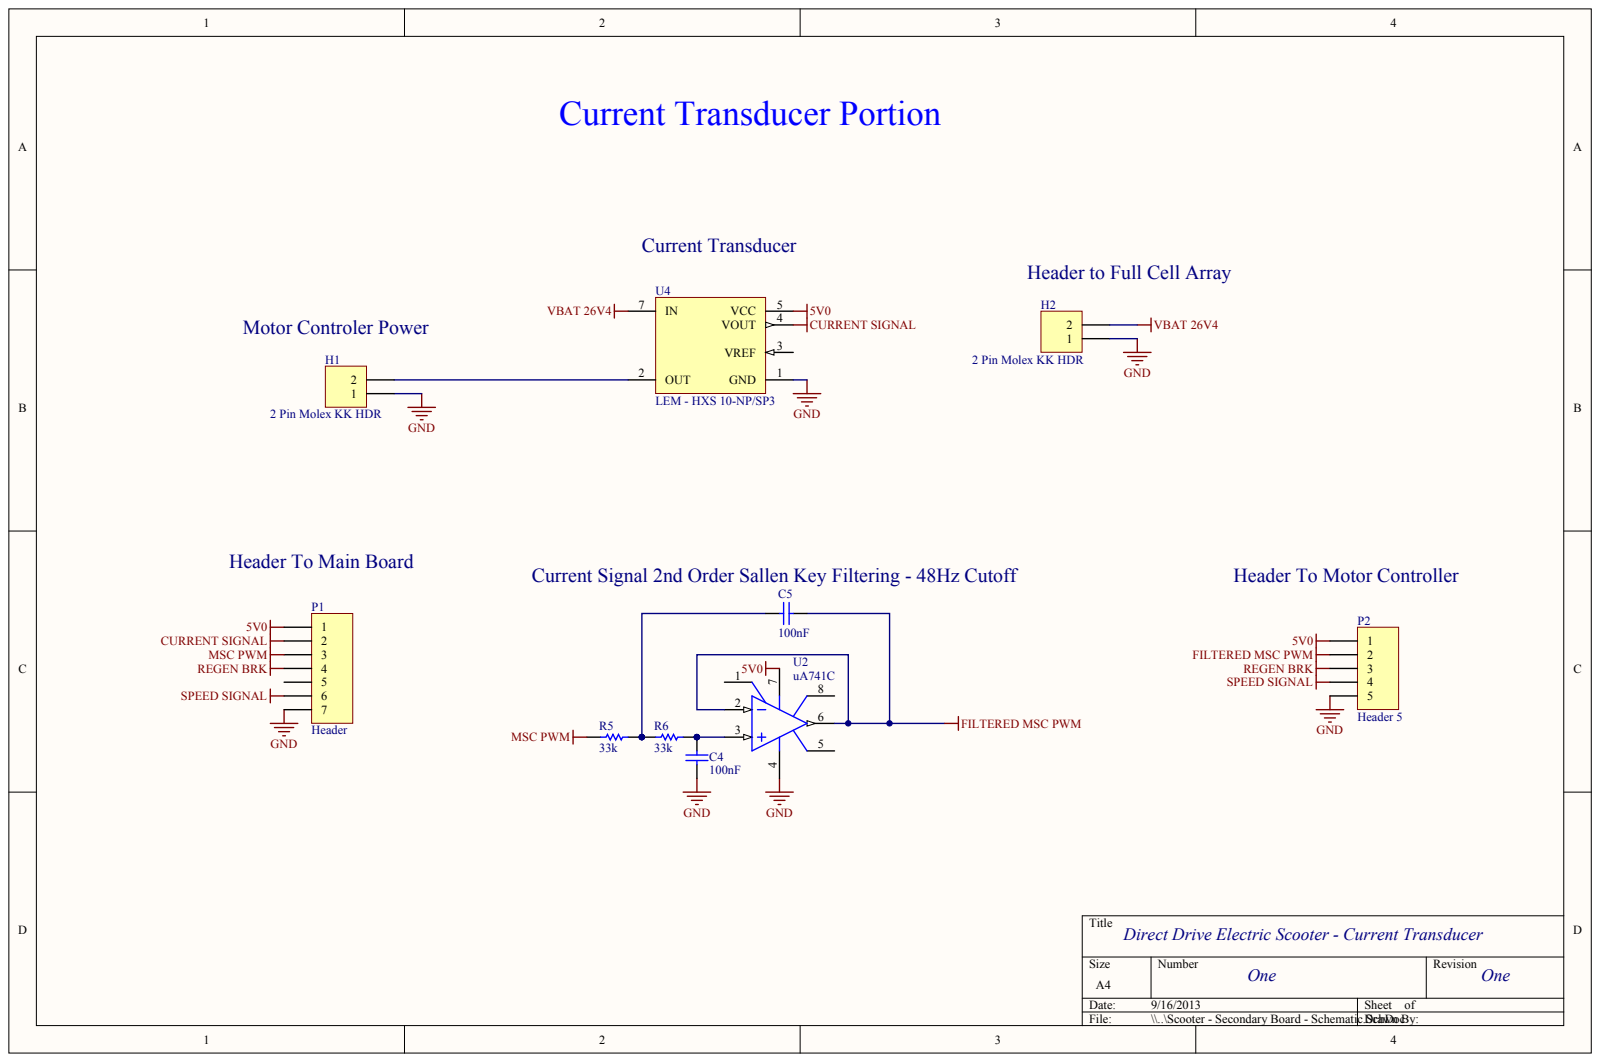
[picture p102: page 1]

Header to Full Cell Array

2 Pin Molex KK HDR 12

Title
Direct Drive Electric Scooter - Current Transducer

Size A4 | Number One | Revision One

Date: 9/16/2013 | Sheet of
File: \\..\Scooter - Secondary Board - Schematic.SchDoc Drawn By | :

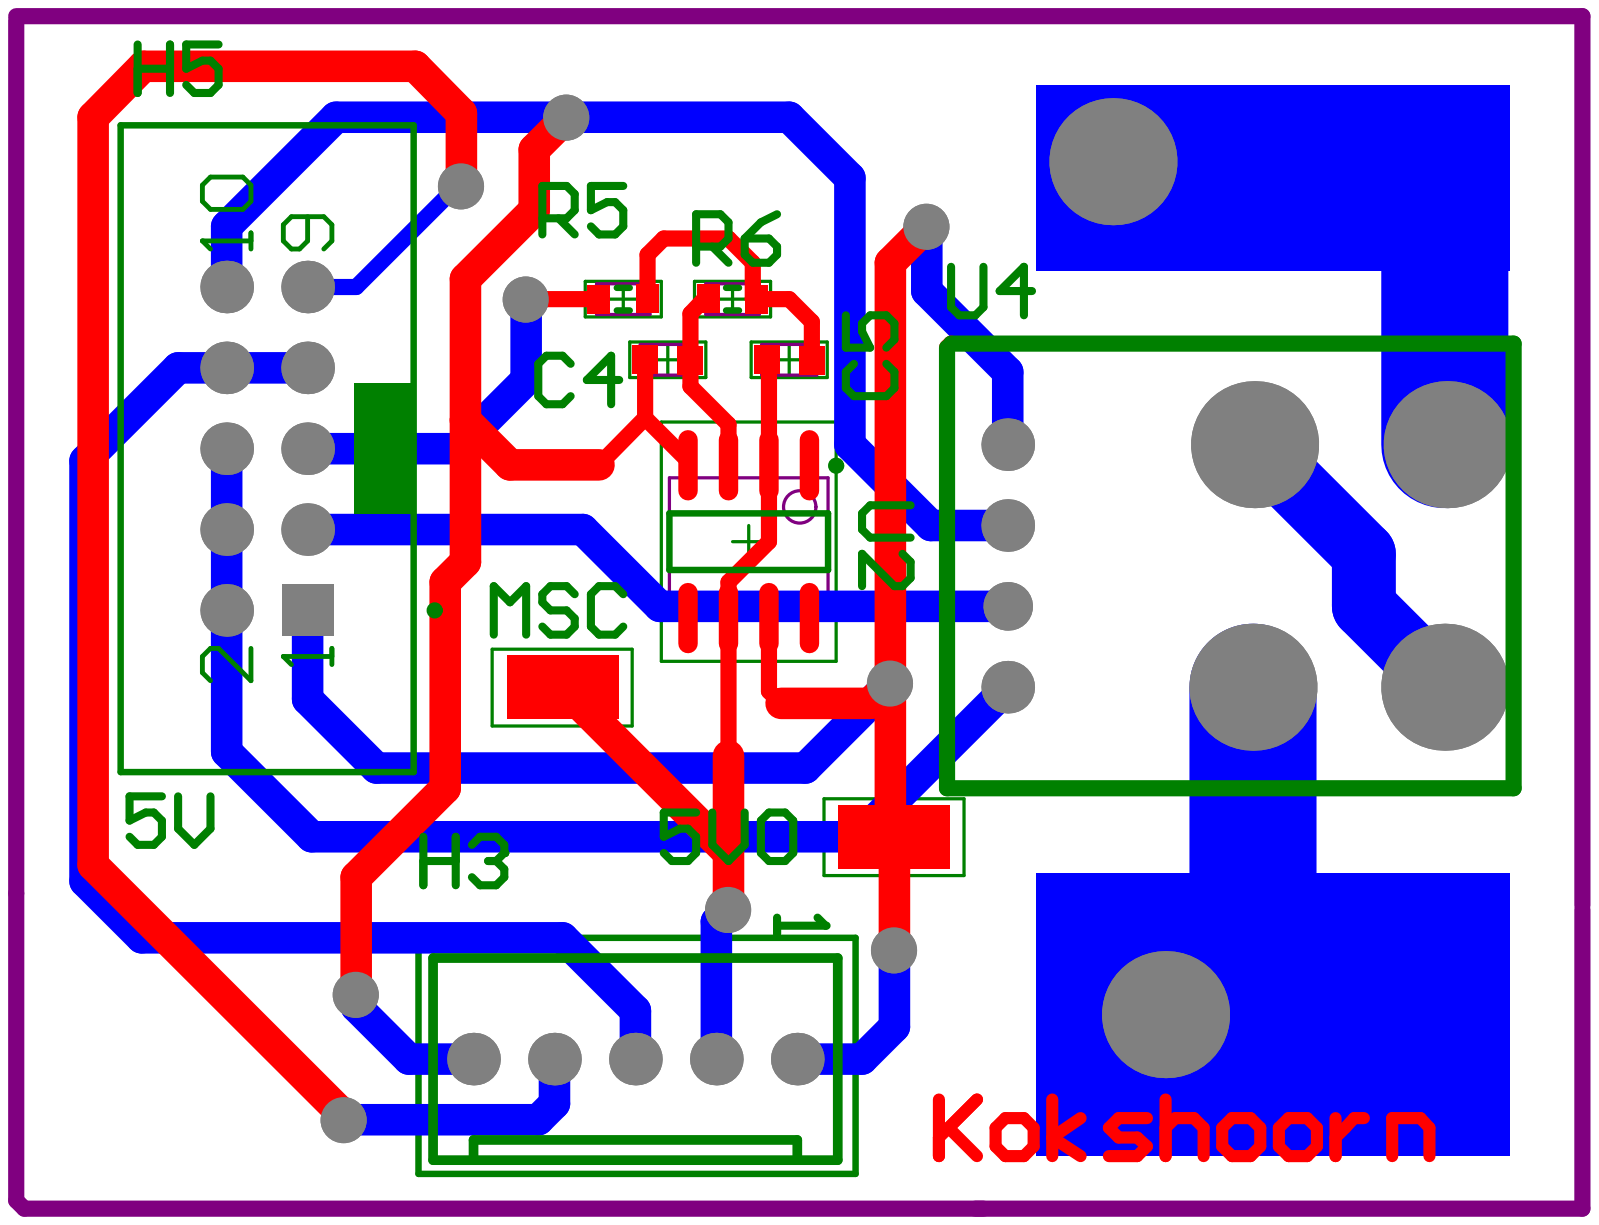
[picture p103: page 2]

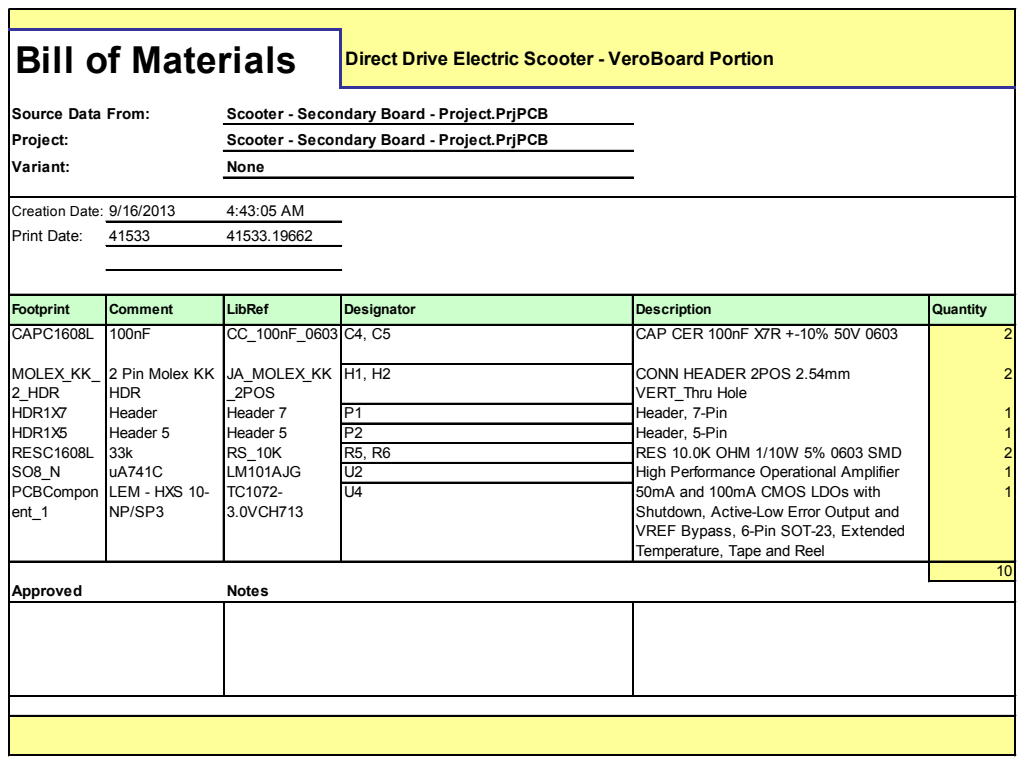
[picture p104: page 3]

Footprint | Comment | LibRef | Designator | Description | Quantity
CAPC1608L MOLEX_KK_ 2_HDR HDR1X7 HDR1X5 RESC1608L SO8_N PCBCompon ent_1 | 100nF 2 Pin Molex KK HDR Header Header 5 33k uA741C LEM - HXS 10-NP/SP3 | CC_100nF_0603 JA_MOLEX_KK _2POS Header 7 Header 5 RS_10K LM101AJG TC1072-3.0VCH713 | C4, C5 | CAP CER 100nF X7R +-10% 50V 0603 CONN HEADER 2POS 2.54mm VERT_Thru Hole Header, 7-Pin Header, 5-Pin RES 10.0K OHM 1/10W 5% 0603 SMD High Performance Operational Amplifier 50mA and 100mA CMOS LDOs with Shutdown, Active-Low Error Output and VREF Bypass, 6-Pin SOT-23, Extended Temperature, Tape and Reel | 2

P1 | | 1
P2 | | 1
R5, R6 | | 2
U2 | | 1

Approved Notes | | | | | 10
