mkokshoorn/Direct-Drive-Electric-Scooter/(list of files, drawings)

Other design files:
Embedded_System/Primary_Circuit/Scooter - Primary Board - PCB Layout.PcbDoc
Embedded_System/Primary_Circuit/Scooter - Primary Board - Project .PrjPCB
Embedded_System/Primary_Circuit/Scooter - Primary Board - Schematic.SchDoc
Embedded_System/Secondary_Circuit/Scooter - Secondary Board - PCB Layout.PcbDoc
Embedded_System/Secondary_Circuit/Scooter - Secondary Board - Project.PrjPCB
Embedded_System/Secondary_Circuit/Scooter - Secondary Board - Schematic.SchDoc
