mkokshoorn/Direct-Drive-Electric-Scooter/Embedded_System/Source_Code/configuration_bits.c

/******************************************************************************/
/* Files to Include                                                           */
/******************************************************************************/

#if defined(__XC)
    #include <xc.h>         /* XC8 General Include File */
#elif defined(HI_TECH_C)
    #include <htc.h>        /* HiTech General Include File */
#elif defined(__18CXX)
    #include <p18cxxx.h>    /* C18 General Include File */
#endif

/******************************************************************************/
/* Configuration Bits                                                         */
/*                                                                            */
/* Refer to 'HI-TECH PICC and PICC18 Toolchains > PICC18 Configuration        */
/* Settings' under Help > Contents in MPLAB X IDE for available PIC18         */
/* Configuration Bit Settings for the correct macros when using the C18       */
/* compiler.  When using the Hi-Tech PICC18 compiler, refer to the compiler   */
/* manual.pdf in the compiler installation doc directory section on           */
/* 'Configuration Fuses'.  The device header file in the HiTech PICC18        */
/* compiler installation directory contains the available macros to be        */
/* embedded.  The XC8 compiler contains documentation on the configuration    */
/* bit macros within the compiler installation /docs folder in a file called  */
/* pic18_chipinfo.html.                                                       */
/*                                                                            */
/* For additional information about what the hardware configurations mean in  */
/* terms of device operation, refer to the device datasheet.                  */
/*                                                                            */
/* General C18/XC8 syntax for configuration macros:                           */
/* #pragma config <Macro Name>=<Setting>, <Macro Name>=<Setting>, ...         */
/*                                                                            */
/* General HiTech PICC18 syntax:                                              */
/* __CONFIG(n,x);                                                             */
/*                                                                            */
/* n is the config word number and x represents the anded macros from the     */
/* device header file in the PICC18 compiler installation include directory.  */
/*                                                                            */
/* A feature of MPLAB X is the 'Generate Source Code to Output' utility in    */
/* the Configuration Bits window.  Under Window > PIC Memory Views >          */
/* Configuration Bits, a user controllable configuration bits window is       */
/* available to Generate Configuration Bits source code which the user can    */
/* paste into this project.                                                   */
/*                                                                            */
/******************************************************************************/




// PIC18F25K50 Configuration Bit Settings

#include <p18F25K50.h>

// CONFIG1L
#pragma config PLLSEL = PLL4X   // PLL Selection (4x clock multiplier)
#pragma config CFGPLLEN = OFF   // PLL Enable Configuration bit (PLL Disabled (firmware controlled))
#pragma config CPUDIV = NOCLKDIV// CPU System Clock Postscaler (CPU uses system clock (no divide))
#pragma config LS48MHZ = SYS24X4// Low Speed USB mode with 48 MHz system clock (System clock at 24 MHz, USB clock divider is set to 4)

// CONFIG1H
#pragma config FOSC = INTOSCIO  // Oscillator Selection (Internal oscillator)
#pragma config PCLKEN = ON      // Primary Oscillator Shutdown (Primary oscillator enabled)
#pragma config FCMEN = OFF      // Fail-Safe Clock Monitor (Fail-Safe Clock Monitor disabled)
#pragma config IESO = OFF       // Internal/External Oscillator Switchover (Oscillator Switchover mode disabled)

// CONFIG2L
#pragma config nPWRTEN = OFF    // Power-up Timer Enable (Power up timer disabled)
#pragma config BOREN = SBORDIS  // Brown-out Reset Enable (BOR enabled in hardware (SBOREN is ignored))
#pragma config BORV = 190       // Brown-out Reset Voltage (BOR set to 1.9V nominal)
#pragma config nLPBOR = OFF     // Low-Power Brown-out Reset (Low-Power Brown-out Reset disabled)

// CONFIG2H
#pragma config WDTEN = ON       // Watchdog Timer Enable bits (WDT enabled in hardware (SWDTEN ignored))
#pragma config WDTPS = 32768    // Watchdog Timer Postscaler (1:32768)

// CONFIG3H
#pragma config CCP2MX = RC1     // CCP2 MUX bit (CCP2 input/output is multiplexed with RC1)
#pragma config PBADEN = ON      // PORTB A/D Enable bit (PORTB<5:0> pins are configured as analog input channels on Reset)
#pragma config T3CMX = RC0      // Timer3 Clock Input MUX bit (T3CKI function is on RC0)
#pragma config SDOMX = RB3      // SDO Output MUX bit (SDO function is on RB3)
#pragma config MCLRE = ON       // Master Clear Reset Pin Enable (MCLR pin enabled; RE3 input disabled)

// CONFIG4L
#pragma config STVREN = ON      // Stack Full/Underflow Reset (Stack full/underflow will cause Reset)
#pragma config LVP = OFF        // Single-Supply ICSP Enable bit (Single-Supply ICSP disabled)
#pragma config XINST = ON       // Extended Instruction Set Enable bit (Instruction set extension and Indexed Addressing mode enabled)

// CONFIG5L
#pragma config CP0 = OFF        // Block 0 Code Protect (Block 0 is not code-protected)
#pragma config CP1 = OFF        // Block 1 Code Protect (Block 1 is not code-protected)
#pragma config CP2 = OFF        // Block 2 Code Protect (Block 2 is not code-protected)
#pragma config CP3 = OFF        // Block 3 Code Protect (Block 3 is not code-protected)

// CONFIG5H
#pragma config CPB = OFF        // Boot Block Code Protect (Boot block is not code-protected)
#pragma config CPD = OFF        // Data EEPROM Code Protect (Data EEPROM is not code-protected)

// CONFIG6L
#pragma config WRT0 = OFF       // Block 0 Write Protect (Block 0 (0800-1FFFh) is not write-protected)
#pragma config WRT1 = OFF       // Block 1 Write Protect (Block 1 (2000-3FFFh) is not write-protected)
#pragma config WRT2 = OFF       // Block 2 Write Protect (Block 2 (04000-5FFFh) is not write-protected)
#pragma config WRT3 = OFF       // Block 3 Write Protect (Block 3 (06000-7FFFh) is not write-protected)

// CONFIG6H
#pragma config WRTC = OFF       // Configuration Registers Write Protect (Configuration registers (300000-3000FFh) are not write-protected)
#pragma config WRTB = OFF       // Boot Block Write Protect (Boot block (0000-7FFh) is not write-protected)
#pragma config WRTD = OFF       // Data EEPROM Write Protect (Data EEPROM is not write-protected)

// CONFIG7L
#pragma config EBTR0 = OFF      // Block 0 Table Read Protect (Block 0 is not protected from table reads executed in other blocks)
#pragma config EBTR1 = OFF      // Block 1 Table Read Protect (Block 1 is not protected from table reads executed in other blocks)
#pragma config EBTR2 = OFF      // Block 2 Table Read Protect (Block 2 is not protected from table reads executed in other blocks)
#pragma config EBTR3 = OFF      // Block 3 Table Read Protect (Block 3 is not protected from table reads executed in other blocks)

// CONFIG7H
#pragma config EBTRB = OFF      // Boot Block Table Read Protect (Boot block is not protected from table reads executed in other blocks)
