mkokshoorn/Direct-Drive-Electric-Scooter/Embedded_System/Source_Code/scooter_interrupts.h

/******************************************************************************/
/*
 * File:   scooter_timer.h
 * Author: Matt Kokshoorn
 *
 * Created on July 3, 2013, 10:21 PM
/******************************************************************************/

#ifndef SCOOTER_INTERRUPTS_H
#define	SCOOTER_INTERRUPTS_H


void interrupts_init(void);



#ifdef	__cplusplus
extern "C" {
#endif


#ifdef	__cplusplus
}
#endif

#endif	/* SCOOTER_INTERRUPTS_H */
