mkokshoorn/Direct-Drive-Electric-Scooter/Embedded_System/Source_Code/scooter_tasks.h

/* 
 * File:   scooter_tasks.h
 * Author: Matt
 *
 * Created on 7 August 2013, 2:57 AM
 */

#ifndef SCOOTER_TASKS_H
#define	SCOOTER_TASKS_H

#define SCOOTER_IDLE_PWM 1500
#define SCOOTER_MAX_PWM  5000

#ifdef	__cplusplus
extern "C" {
#endif


char check_break(void);



#ifdef	__cplusplus
}
#endif

#endif	/* SCOOTER_TASKS_H */
