mkokshoorn/Direct-Drive-Electric-Scooter/Embedded_System/Source_Code/system.h

/******************************************************************************/
/* System Level #define Macros                                                */
/******************************************************************************/

/* TODO Define system operating frequency */

/* Microcontroller MIPs (FCY) */
#define SYS_FREQ        16000000L
#define FCY             SYS_FREQ/4

/******************************************************************************/
/* System Function Prototypes                                                 */
/******************************************************************************/

/* Custom oscillator configuration funtions, reset source evaluation
functions, and other non-peripheral microcontroller initialization functions
go here. */

void ConfigureOscillator(void); /* Handles clock switching/osc initialization */
